JS2028EE/ESP32_FC/hardware/revB/Sources.md

# Manufacturer sources for Rev B

- ESP32-S3 module, pins, memory options and temperature: https://www.espressif.com/sites/default/files/documentation/esp32-s3-wroom-1_wroom-1u_datasheet_en.pdf
- ESP32 schematic/USB guidelines: https://docs.espressif.com/projects/esp-hardware-design-guidelines/en/latest/esp32s3/schematic-checklist.html
- BMI088: https://www.bosch-sensortec.com/media/boschsensortec/downloads/datasheets/bst-bmi088-ds001.pdf
- BMP280: https://www.bosch-sensortec.com/media/boschsensortec/downloads/datasheets/bst-bmp280-ds001.pdf
- LMR36510 component/layout guidance, sections 5 and 8.5: https://www.ti.com/lit/ds/symlink/lmr36510.pdf
- AP63203 components/layout: https://www.diodes.com/assets/Datasheets/AP63200-AP63201-AP63203-AP63205.pdf
- Sensor LDO: https://www.ti.com/lit/ds/symlink/tlv755p.pdf
- LVC125 buffer: https://www.ti.com/lit/ds/symlink/sn74lvc125a.pdf
- DMN2056U SOT23, low gate-voltage ratings: https://www.diodes.com/datasheet/download/DMN2056U.pdf
- Littelfuse 476 fuse (2026-02-25 revision, electrical ratings p1 and lands p3): https://www.littelfuse.com/assetdocs/littelfuse-fuse-476-datasheet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
- C27 Panasonic EEUFR1H470 dimensions/rating: https://industrial.panasonic.com/ww/products/pt/aluminum-cap-lead/models/EEUFR1H470
- C8 KEMET 220nF/100V 0805: https://yageogroup.com/download/specsheet/C0805C224K1RACTU
- Murata 22uF/16V X5R 0805: https://www.murata.com/en-global/products/productdetail?partno=GRM21BR61C226ME44%23
- Murata 22uF/25V X7R 1210: https://www.murata.com/en-us/products/productdetail.aspx?partno=GRM32ER71E226ME15%23 (tolerance suffix differs for the selected K/10% part)
- Murata 4.7uF/16V X5R 0603: https://www.murata.com/products/productdetail?partno=GRM188R61C475KE11%23
- TI reference BOM identifying GRM32ER72A225KA35L as 2.2uF/100V X7R 1210: https://www.ti.com/lit/pdf/tidrrv2
- Kingbright 0603 indicator: https://www.kingbrightusa.com/images/catalog/spec/apt1608lzgck.pdf
- Bourns inductors: https://www.bourns.com/docs/Product-Datasheets/SRP6060FA.pdf and https://www.bourns.com/docs/Product-Datasheets/SRP5030T.pdf
- JLCPCB fabrication capabilities and nominal stackups: https://jlcpcb.com/capabilities/pcb-capabilities and https://jlcpcb.com/impedance
- Reference ESC: https://holybro.com/products/tekko32-f4-4in1-50a-esc and current scale by PCB revision: https://docs.holybro.com/esc/current-sensor-scale

Reviewed for this revision on 2026-10-15. Manufacturer documentation and sourcing can change; verify the purchased variants. These sources support design choices, not a claim that the assembled board has passed testing.
