JS2028EE/ESP32_FC/THIRD_PARTY_NOTICES.md

# Licensing and third-party material

No project-wide open-source license has been selected for this repository. Public availability alone is not a project-wide license grant. No MIT, CERN-OHL or other license is asserted here on the owner's behalf. A license can be added separately by the owner.

The KiCad project contains embedded/library-derived symbols and footprints, including locally adapted footprints. Upstream library copyright, attribution and applicable terms remain relevant; this document does not replace or override them. Consult the license and attribution for the precise KiCad library revision used before redistributing library material. The original library revision is not pinned in this snapshot.

Manufacturer datasheets and product pages are linked in [Sources.md](hardware/revB/Sources.md); those documents are not copied into the repository. Manufacturer names, part numbers and trademarks identify compatible design references and do not imply sponsorship or certification.
