JS2028EE/ESP32_FC/hardware/revB/Assembly_Top.pdf

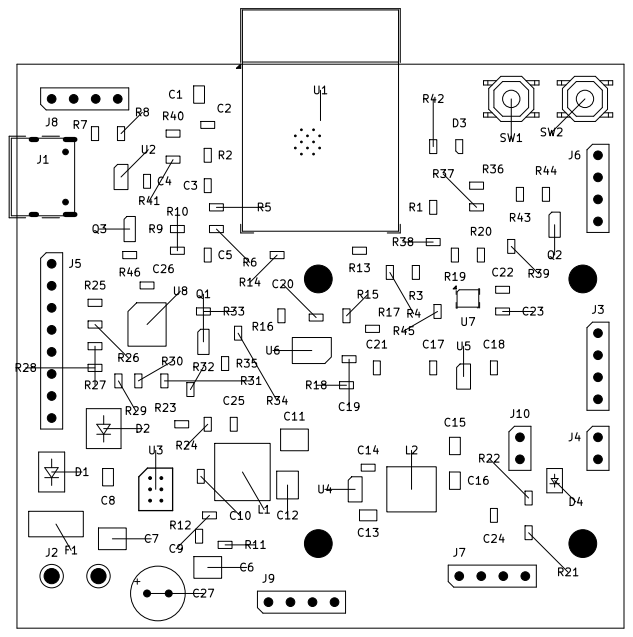
[picture p7: page 1]
