JS2028EE/ESP32_FC/hardware/revB/ESP32_FC.kicad_pcb

## KiCad design hardware/revB/ESP32_FC.kicad_pcb (2026-10-16)

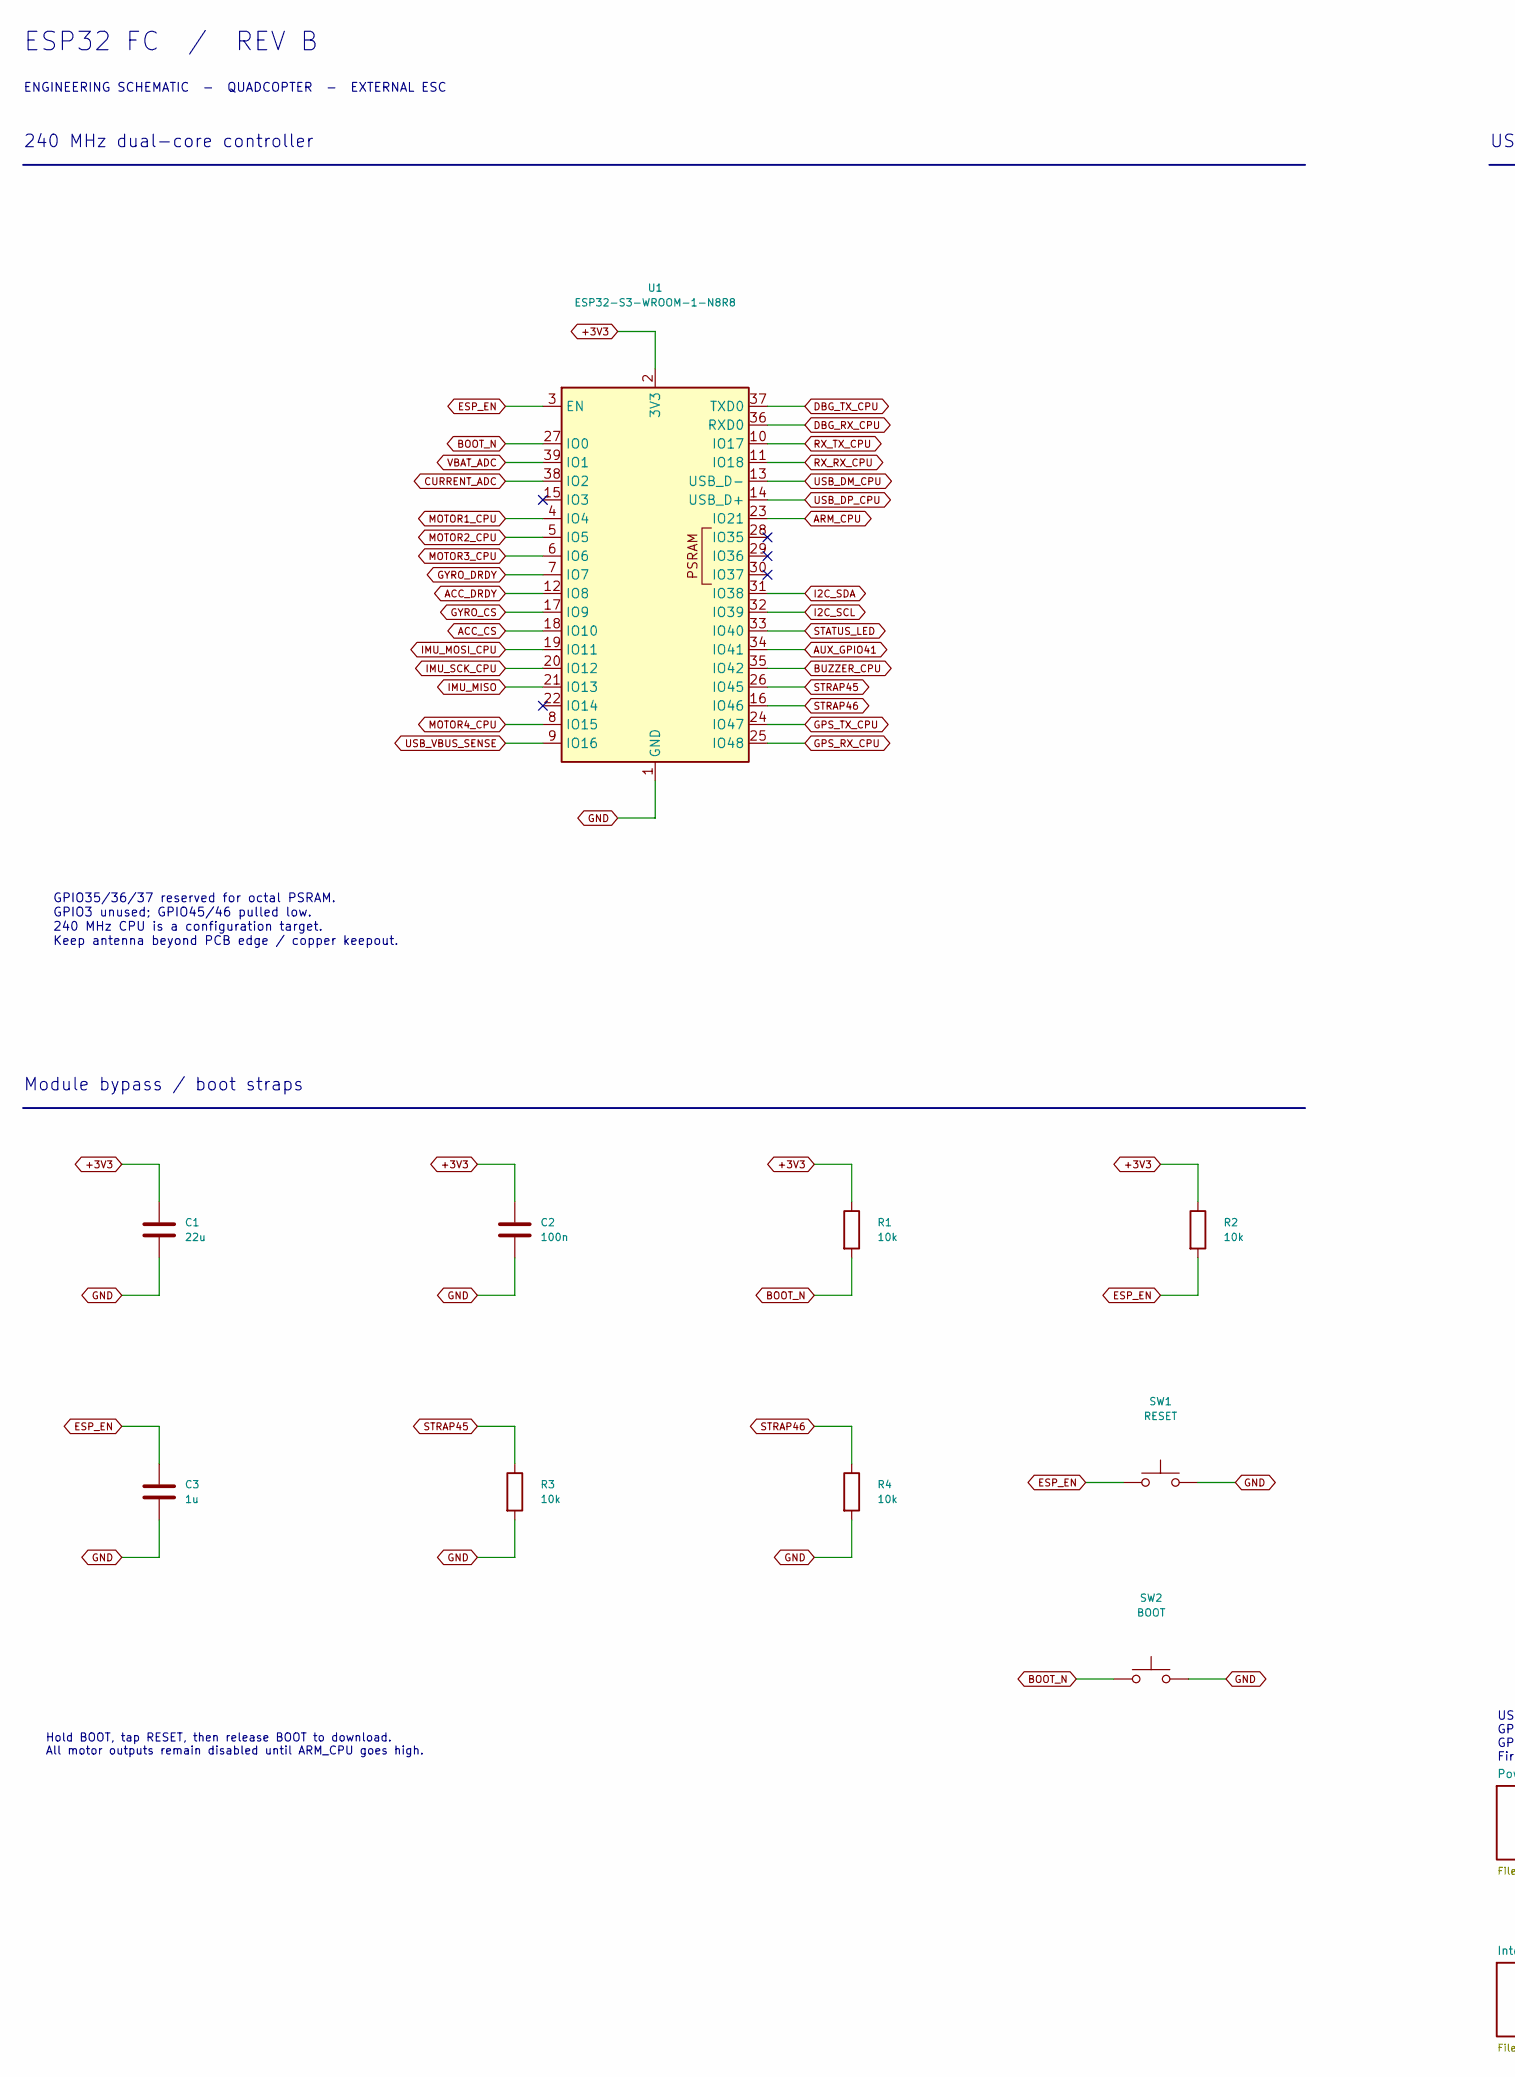
[picture p8: schematic ESP32_FC.kicad_sch, 01 Processor and USB, part in row 1, column 1]

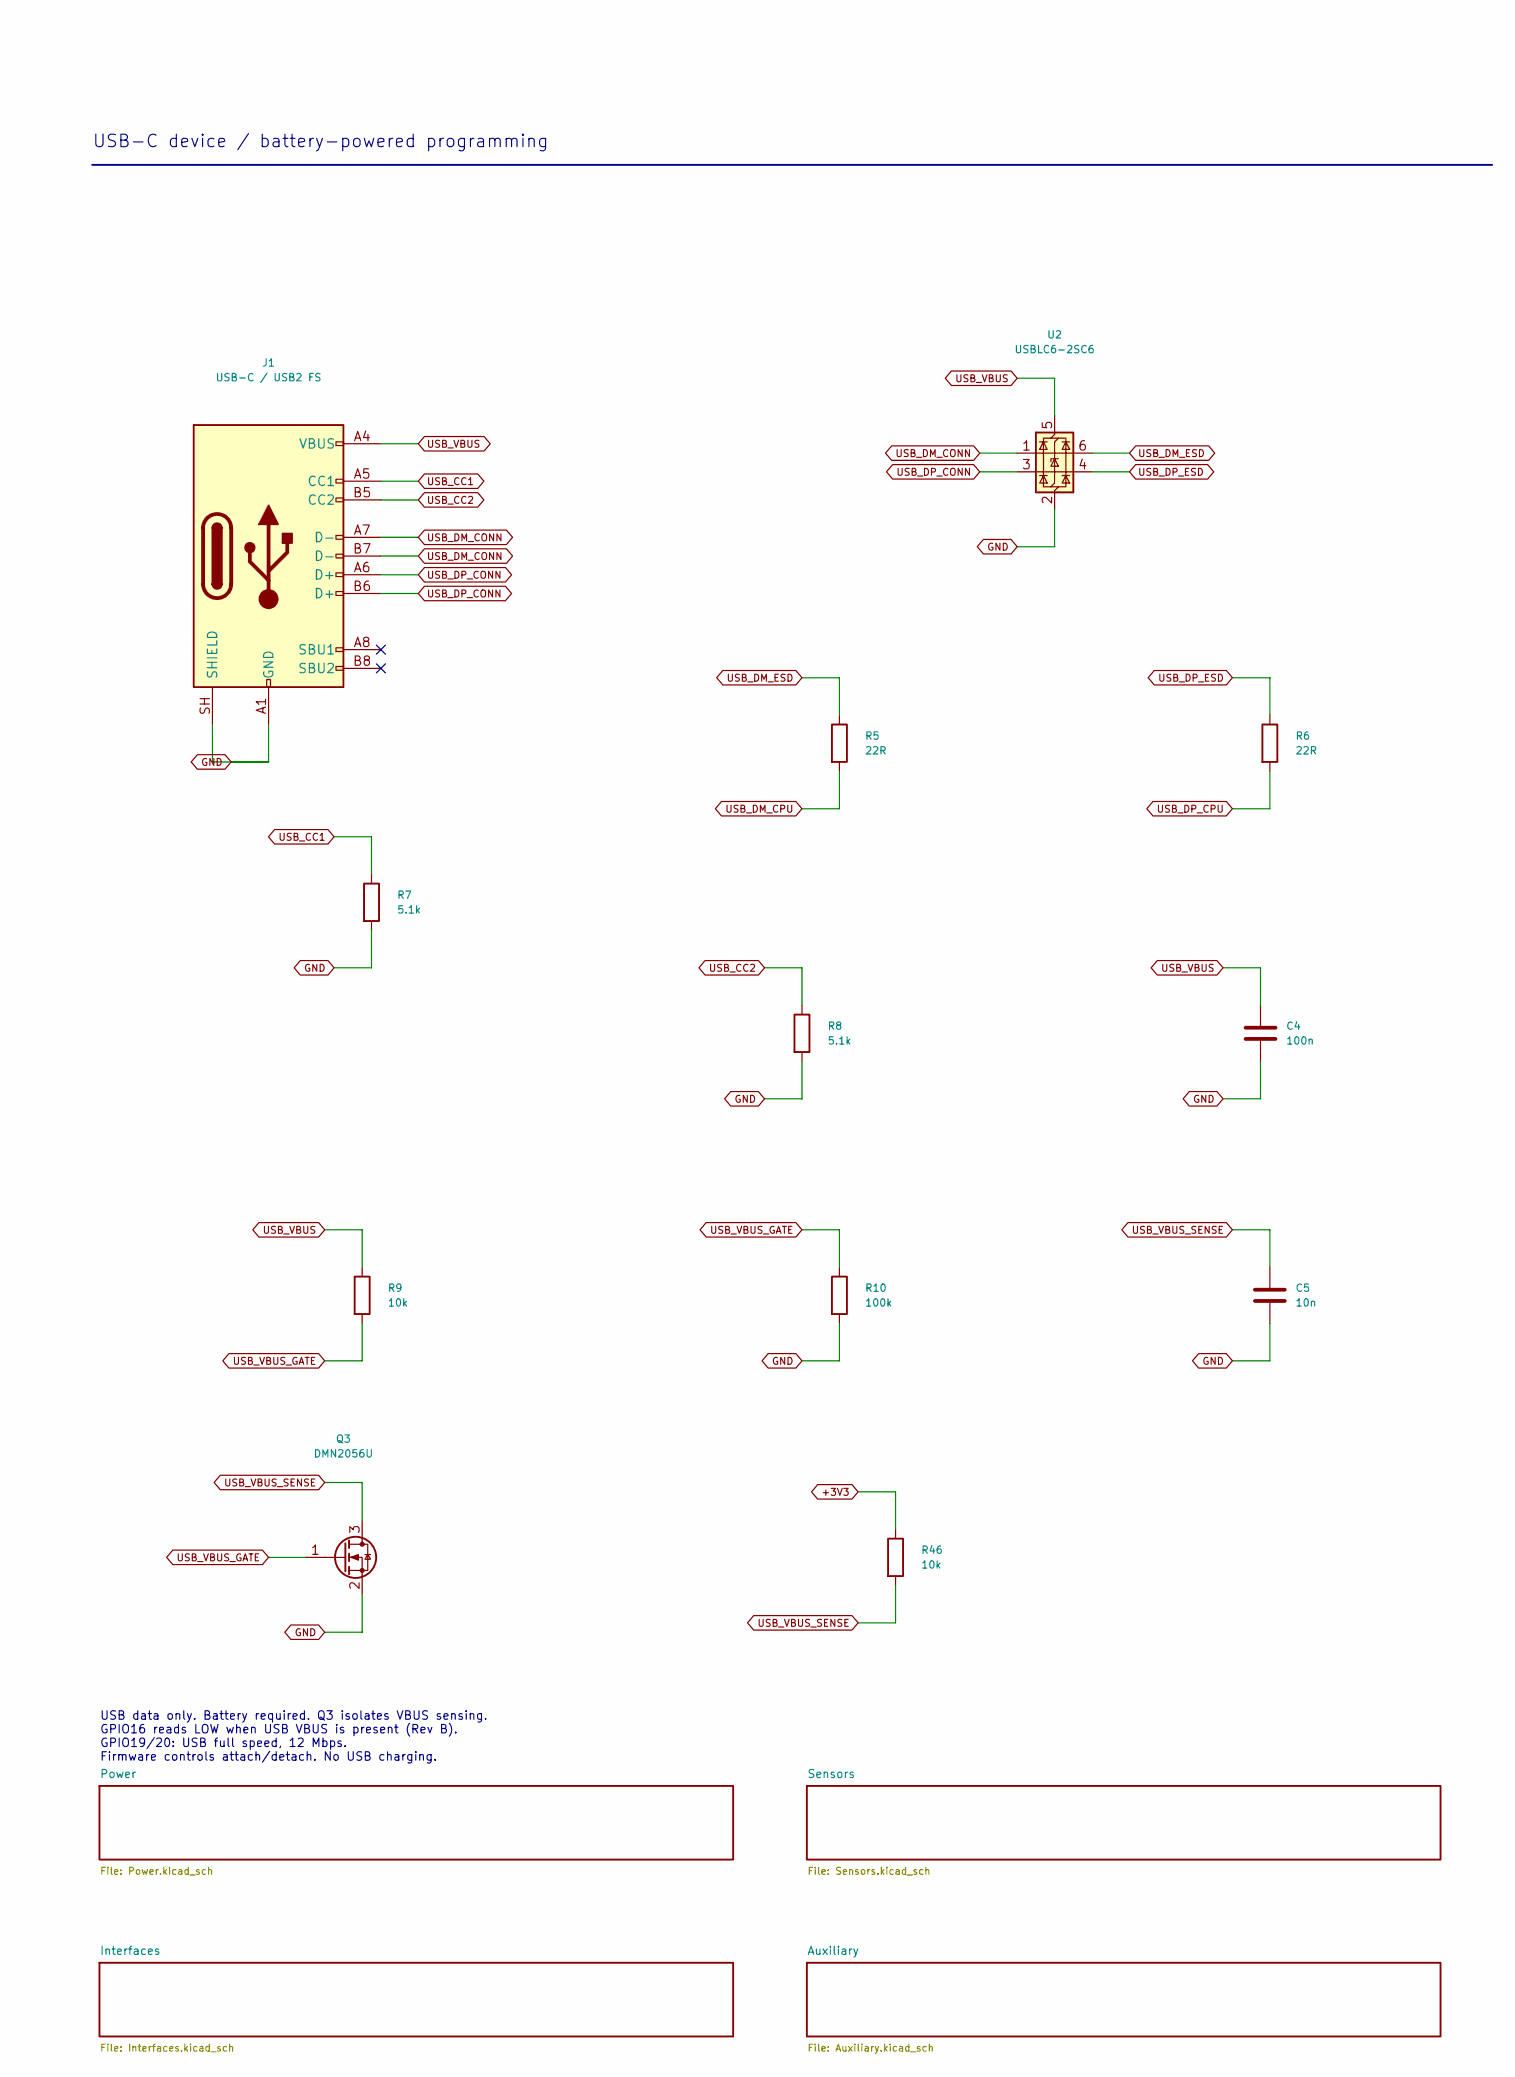
[picture p9: schematic ESP32_FC.kicad_sch, 01 Processor and USB, part in row 1, column 2]

Parts:
C1: 22u; C_0805_2012Metric; MPN GRM21BR61C226ME44L
C2, C4: 100n; C_0603_1608Metric; MPN GRM188R71C104KA01D
C3: 1u; C_0603_1608Metric; MPN GRM188R71C105KA12D
C5: 10n; C_0603_1608Metric; MPN GRM188R71H103KA01D
J1: USB-C / USB2 FS; USB_C_HRO_Edge; MPN TYPE-C-31-M-12
Q3: DMN2056U; SOT-23; MPN DMN2056U-7
R1, R2, R3, R4, R9, R46: 10k; R_0603_1608Metric; MPN RC0603FR-0710KL
R5, R6: 22R; R_0603_1608Metric; MPN RC0603FR-0722RL
R7, R8: 5.1k; R_0603_1608Metric; MPN RC0603FR-075K1L
R10: 100k; R_0603_1608Metric; MPN RC0603FR-07100KL
SW1: RESET; SW_SPST_TL3342; MPN TL3342F160QG
SW2: BOOT; SW_SPST_TL3342; MPN TL3342F160QG
U1: ESP32-S3-WROOM-1-N8R8; ESP32_S3_WROOM_Edge; MPN ESP32-S3-WROOM-1-N8R8
U2: USBLC6-2SC6; SOT-23-6; MPN USBLC6-2SC6

Connections:
+3V3: C1.1, C2.1, R1.1, R2.1, R46.1, U1.2 (3V3); also elsewhere on the board
ACC_CS: U1.18 (IO10); also elsewhere on the board
ACC_DRDY: U1.12 (IO8); also elsewhere on the board
ARM_CPU: U1.23 (IO21); also elsewhere on the board
AUX_GPIO41: U1.34 (IO41); also elsewhere on the board
BOOT_N: R1.2, SW2.1, U1.27 (IO0)
BUZZER_CPU: U1.35 (IO42); also elsewhere on the board
CURRENT_ADC: U1.38 (IO2); also elsewhere on the board
DBG_RX_CPU: U1.36 (RXD0); also elsewhere on the board
DBG_TX_CPU: U1.37 (TXD0); also elsewhere on the board
ESP_EN: C3.1, R2.2, SW1.1, U1.3 (EN)
GND: C1.2, C2.2, C3.2, C4.2, C5.2, J1.A1 (GND), J1.A12 (GND), J1.B1 (GND), J1.B12 (GND), J1.SH (SHIELD), Q3.2 (S), R3.2, R4.2, R7.2, R8.2, R10.2, SW1.2, SW2.2, U1.1 (GND), U1.40 (GND), U1.41 (GND), U2.2 (GND); also elsewhere on the board
GPS_RX_CPU: U1.25 (IO48); also elsewhere on the board
GPS_TX_CPU: U1.24 (IO47); also elsewhere on the board
GYRO_CS: U1.17 (IO9); also elsewhere on the board
GYRO_DRDY: U1.7 (IO7); also elsewhere on the board
I2C_SCL: U1.32 (IO39); also elsewhere on the board
I2C_SDA: U1.31 (IO38); also elsewhere on the board
IMU_MISO: U1.21 (IO13); also elsewhere on the board
IMU_MOSI_CPU: U1.19 (IO11); also elsewhere on the board
IMU_SCK_CPU: U1.20 (IO12); also elsewhere on the board
MOTOR1_CPU: U1.4 (IO4); also elsewhere on the board
MOTOR2_CPU: U1.5 (IO5); also elsewhere on the board
MOTOR3_CPU: U1.6 (IO6); also elsewhere on the board
MOTOR4_CPU: U1.8 (IO15); also elsewhere on the board
RX_RX_CPU: U1.11 (IO18); also elsewhere on the board
RX_TX_CPU: U1.10 (IO17); also elsewhere on the board
STATUS_LED: U1.33 (IO40); also elsewhere on the board
STRAP45: R3.1, U1.26 (IO45)
STRAP46: R4.1, U1.16 (IO46)
USB_CC1: J1.A5 (CC1), R7.1
USB_CC2: J1.B5 (CC2), R8.1
USB_DM_CONN: J1.A7 (D-), J1.B7 (D-), U2.1 (I/O1)
USB_DM_CPU: R5.2, U1.13 (USB_D-)
USB_DM_ESD: R5.1, U2.6 (I/O1)
USB_DP_CONN: J1.A6 (D+), J1.B6 (D+), U2.3 (I/O2)
USB_DP_CPU: R6.2, U1.14 (USB_D+)
USB_DP_ESD: R6.1, U2.4 (I/O2)
USB_VBUS: C4.1, J1.A4 (VBUS), J1.A9 (VBUS), J1.B4 (VBUS), J1.B9 (VBUS), R9.1, U2.5 (VBUS)
USB_VBUS_GATE: Q3.1 (G), R9.2, R10.1
USB_VBUS_SENSE: C5.1, Q3.3 (D), R46.2, U1.9 (IO16)
VBAT_ADC: U1.39 (IO1); also elsewhere on the board

Notes on the sheet:
ESP32 FC / REV B
ENGINEERING SCHEMATIC - QUADCOPTER - EXTERNAL ESC
240 MHz dual-core controller
GPIO35/36/37 reserved for octal PSRAM. GPIO3 unused; GPIO45/46 pulled low. 240 MHz CPU is a configuration target. Keep antenna beyond PCB edge / copper keepout.
Module bypass / boot straps
Hold BOOT, tap RESET, then release BOOT to download. All motor outputs remain disabled until ARM_CPU goes high.
USB-C device / battery-powered programming
USB data only. Battery required. Q3 isolates VBUS sensing. GPIO16 reads LOW when USB VBUS is present (Rev B). GPIO19/20: USB full speed, 12 Mbps. Firmware controls attach/detach. No USB charging.

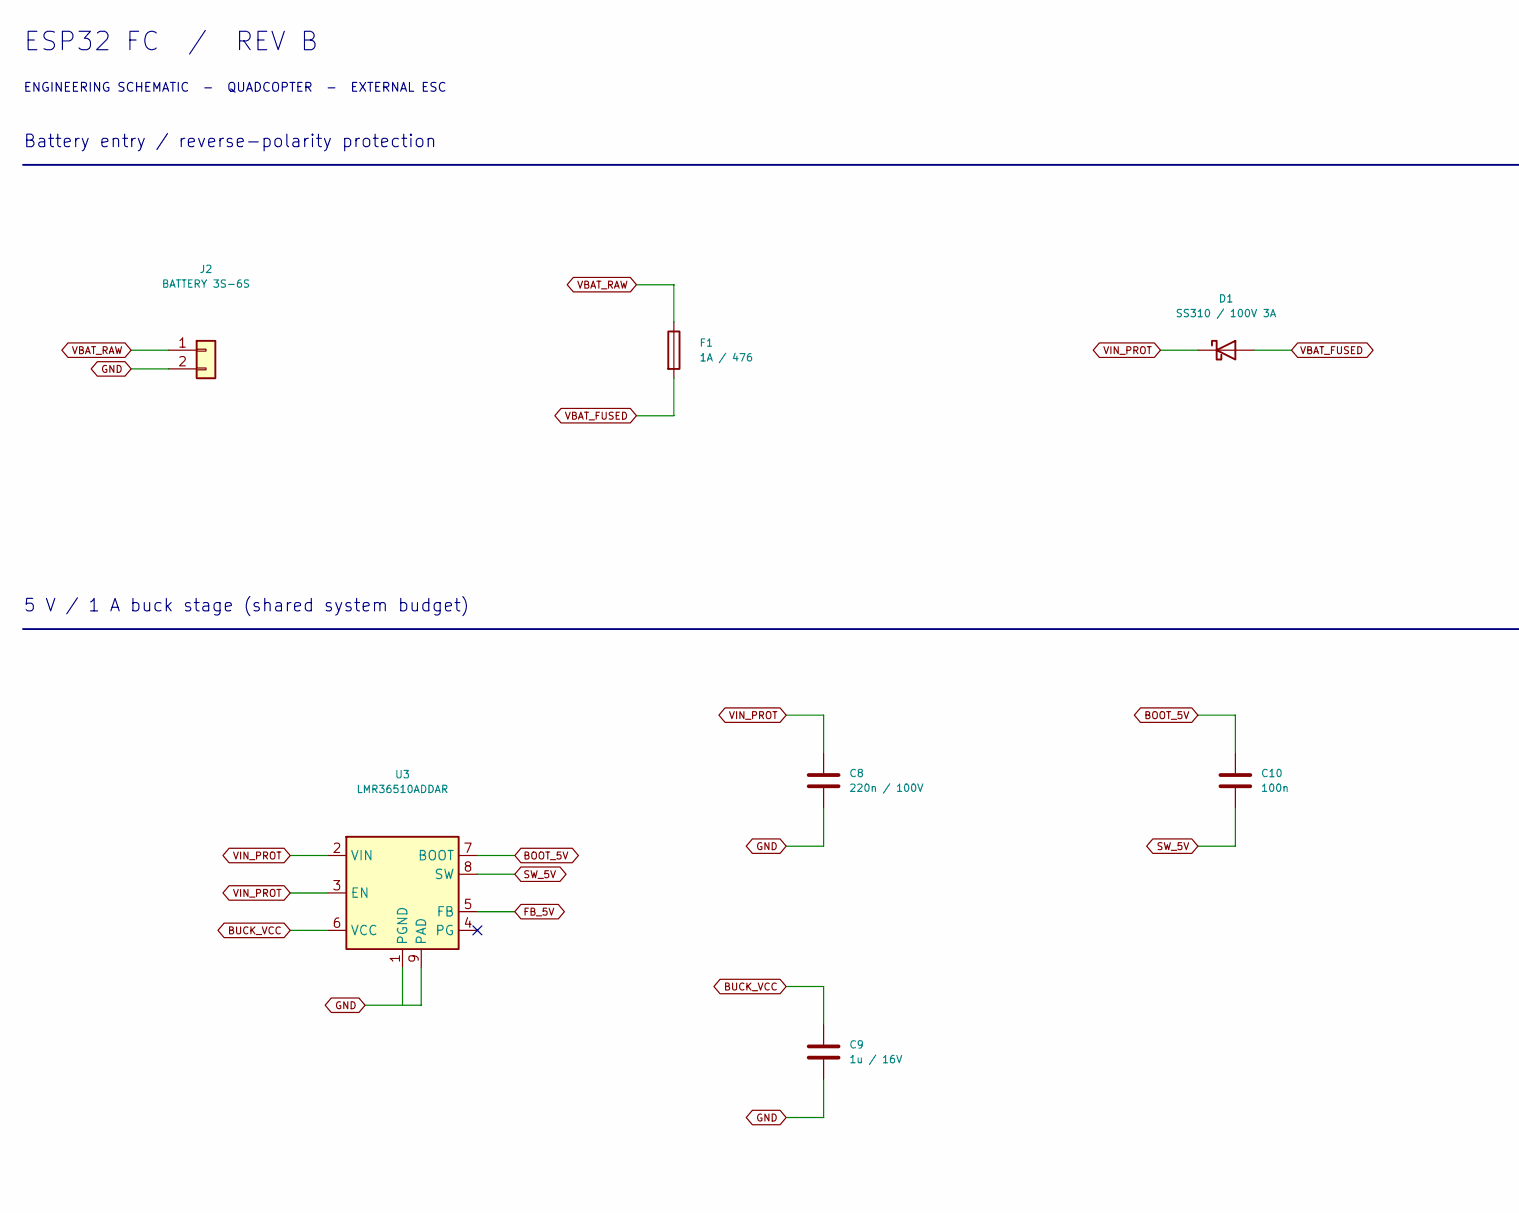
[picture p10: schematic Power.kicad_sch, 02 Battery and regulation, part in row 1, column 1]

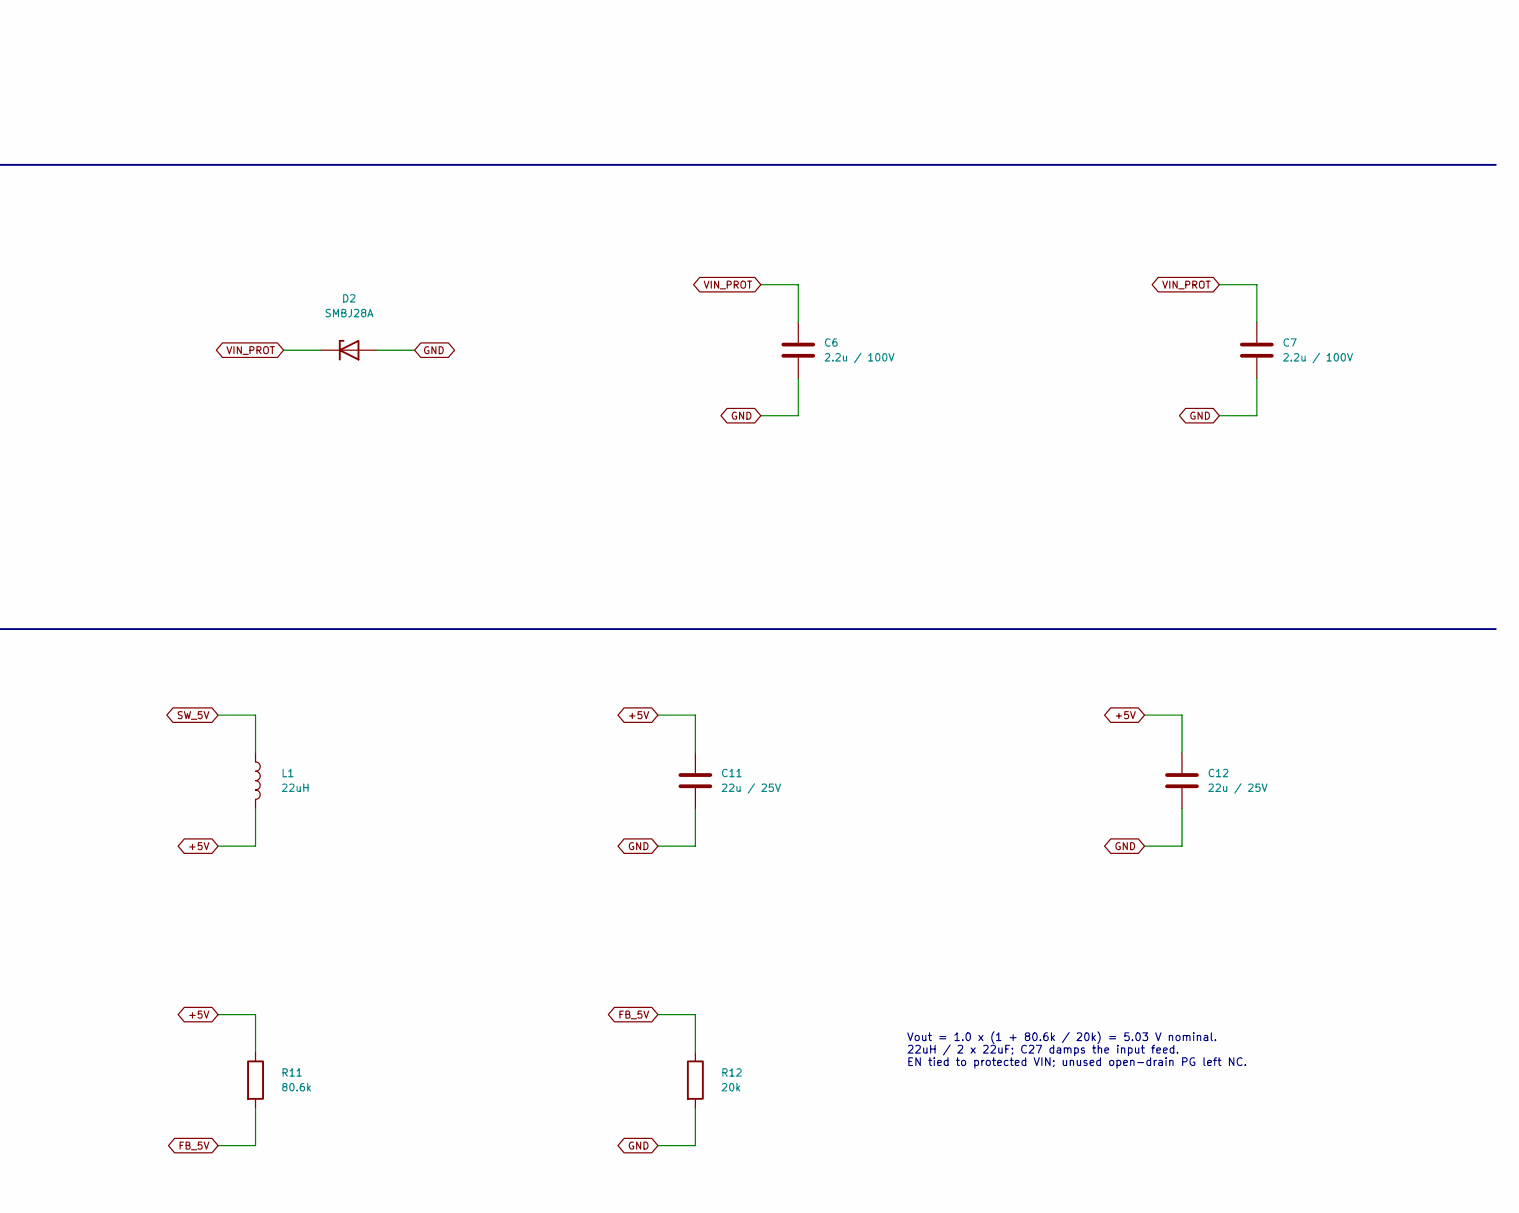
[picture p11: schematic Power.kicad_sch, 02 Battery and regulation, part in row 1, column 2]

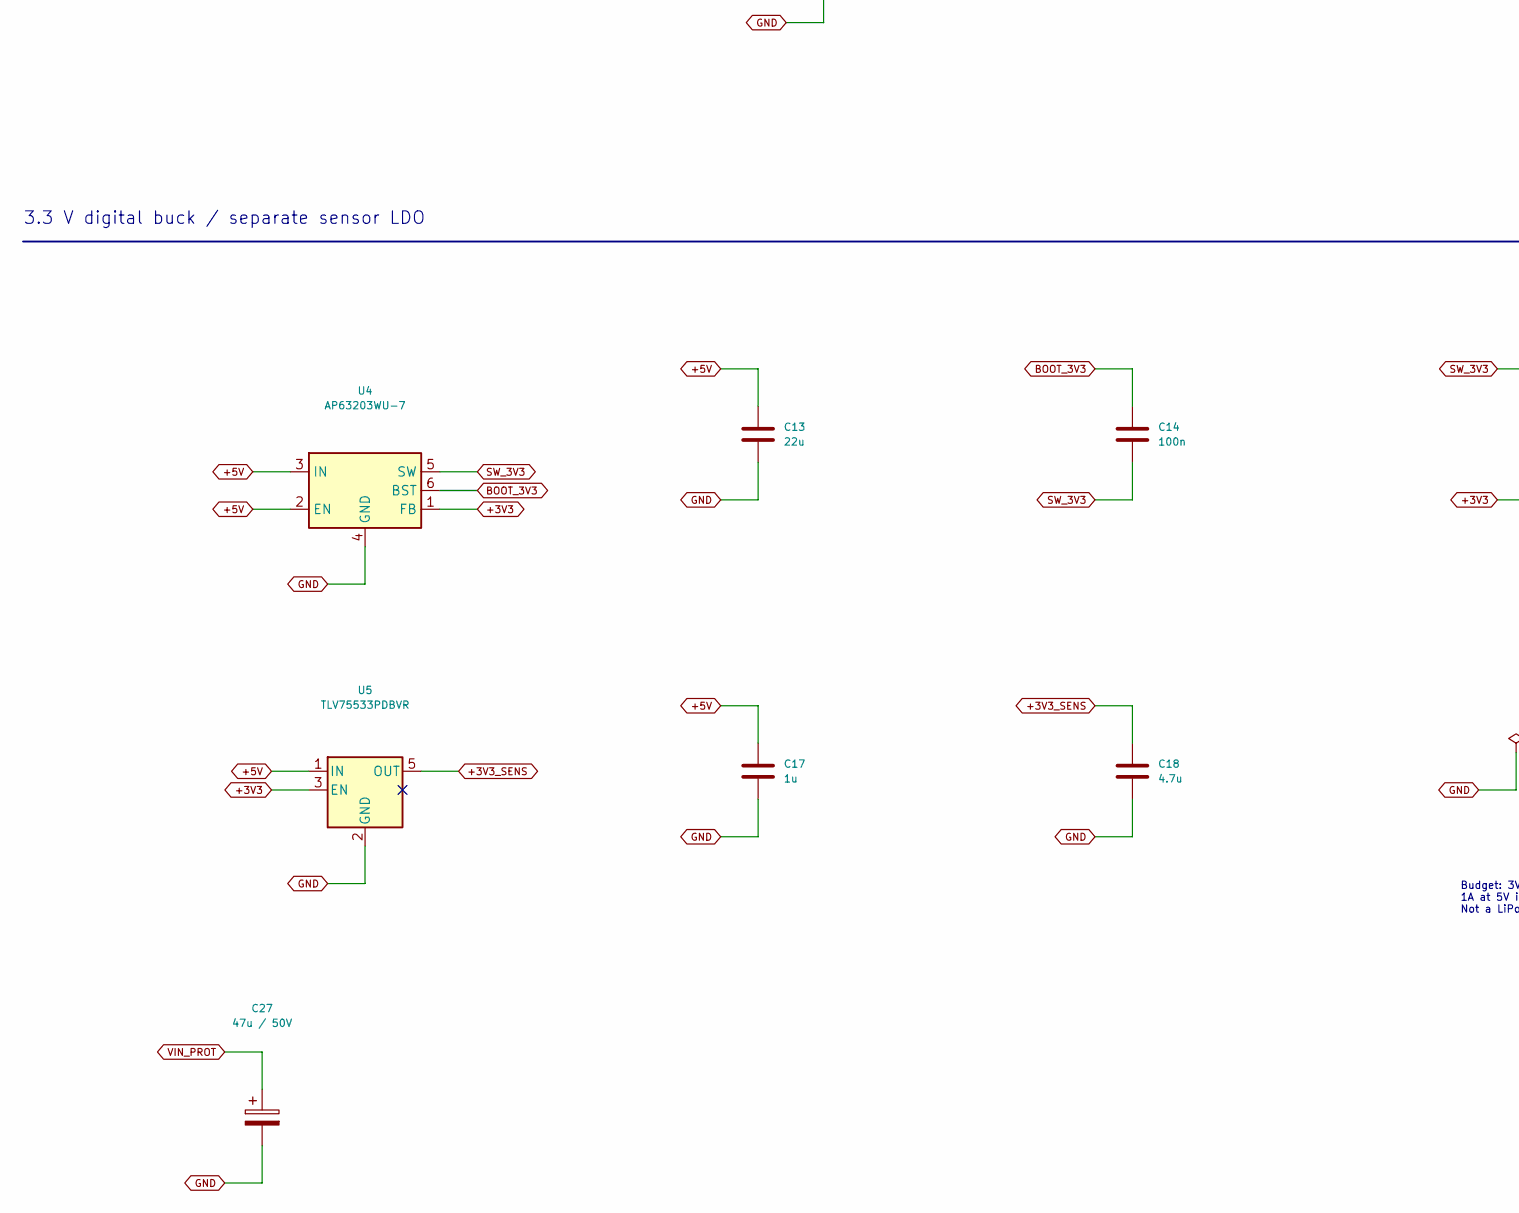
[picture p12: schematic Power.kicad_sch, 02 Battery and regulation, part in row 2, column 1]

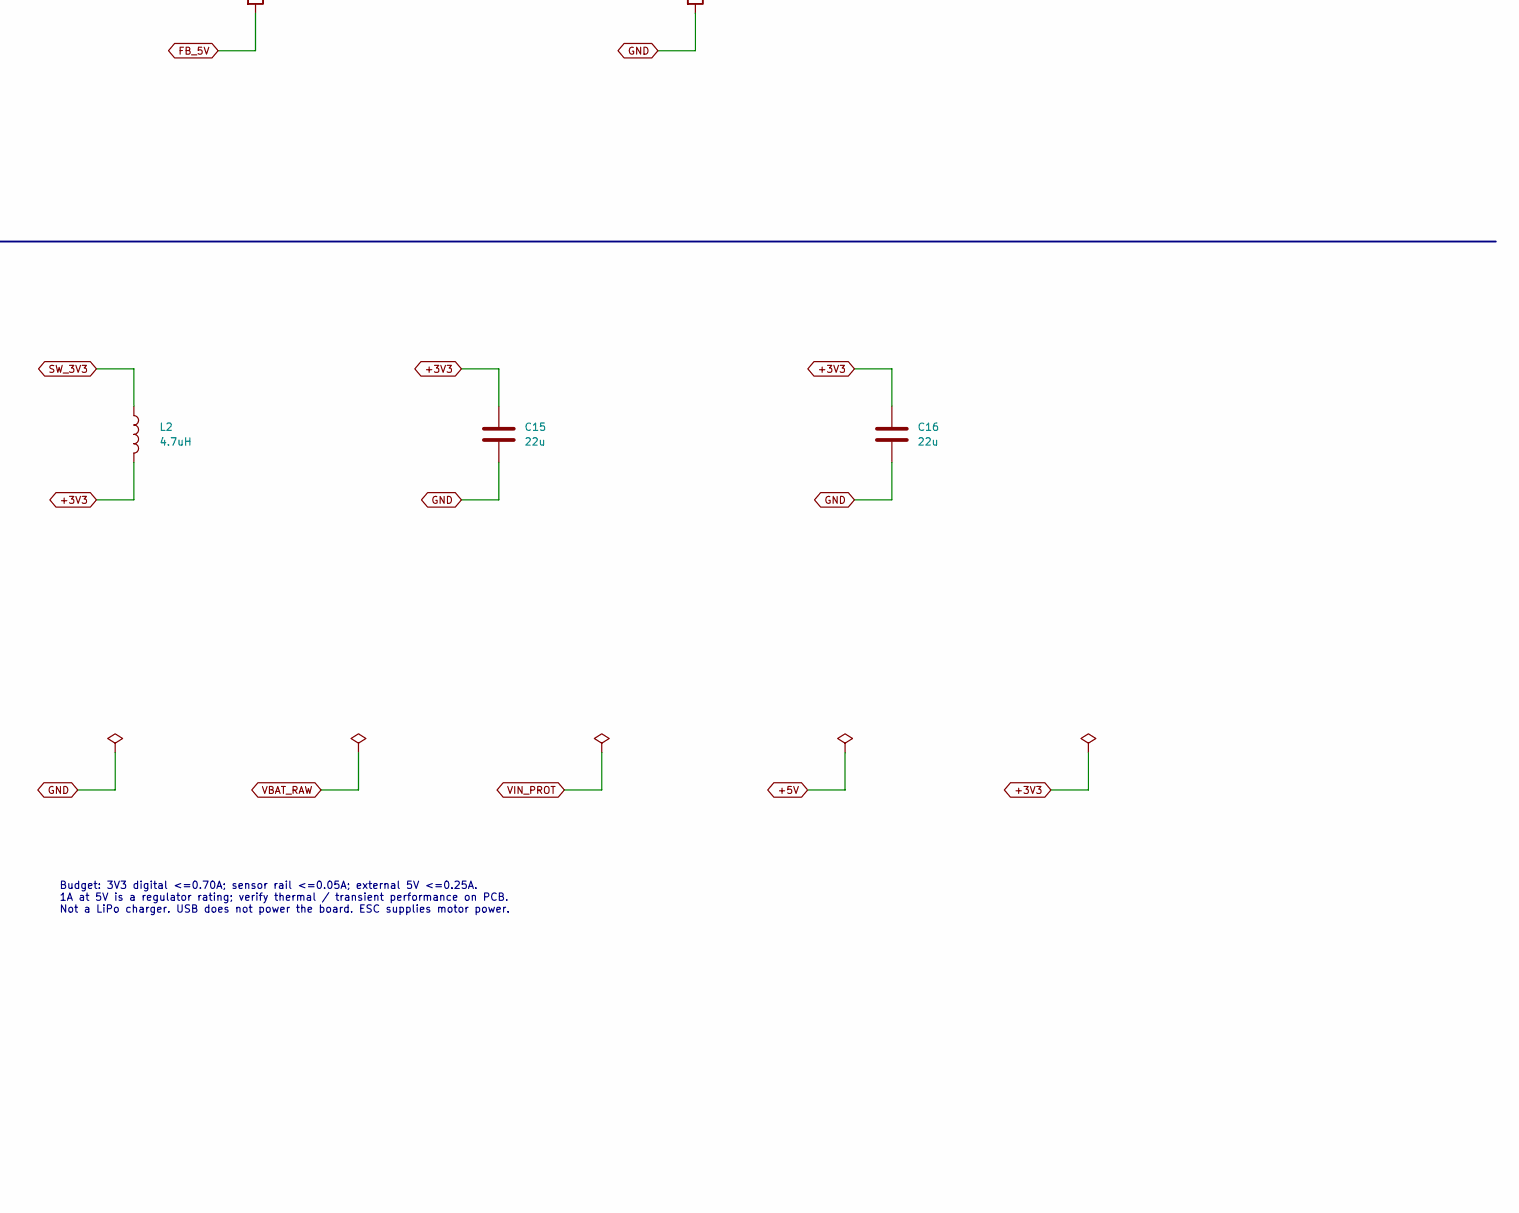
[picture p13: schematic Power.kicad_sch, 02 Battery and regulation, part in row 2, column 2]

Parts:
C6, C7: 2.2u / 100V; C_1210_3225Metric; MPN GRM32ER72A225KA35L
C8: 220n / 100V; C_0805_2012Metric; MPN C0805C224K1RACTU
C9: 1u / 16V; C_0603_1608Metric; MPN GRM188R71C105KA12D
C10, C14: 100n; C_0603_1608Metric; MPN GRM188R71C104KA01D
C11, C12: 22u / 25V; C_1210_3225Metric; MPN GRM32ER71E226KE15L
C13, C15, C16: 22u; C_0805_2012Metric; MPN GRM21BR61C226ME44L
C17: 1u; C_0603_1608Metric; MPN GRM188R71C105KA12D
C18: 4.7u; C_0603_1608Metric; MPN GRM188R61C475KE11D
C27: 47u / 50V; CP_Radial_D6.3mm_P2.50mm; MPN EEUFR1H470
D1: SS310 / 100V 3A; D_SMA; MPN SS310-13-F
D2: SMBJ28A; D_SMB; MPN SMBJ28A-13-F
F1: 1A / 476; Fuse_Littelfuse_476; MPN 0476001.MR
J2: BATTERY 3S-6S; SolderWire-1sqmm_1x02_P5.4mm_D1.4mm_OD2.7mm; MPN WIRE CONNECTION - NO FITTED PART
L1: 22uH; L_Bourns_SRP6060FA; MPN SRP6060FA-220M
L2: 4.7uH; L_Bourns_SRP5030T; MPN SRP5030T-4R7M
R11: 80.6k; R_0603_1608Metric; MPN RC0603FR-0780K6L
R12: 20k; R_0603_1608Metric; MPN RC0603FR-0720KL
U3: LMR36510ADDAR; Texas_HTSOP-8-1EP_3.9x4.9mm_P1.27mm_EP2.95x4.9mm_Mask2.4x3.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; MPN LMR36510ADDAR
U4: AP63203WU-7; TSOT-23-6; MPN AP63203WU-7
U5: TLV75533PDBVR; SOT-23-5; MPN TLV75533PDBVR

Connections:
+3V3: C15.1, C16.1, L2.2, U4.1 (FB), U5.3 (EN); also elsewhere on the board
+3V3_SENS: C18.1, U5.5 (OUT); also elsewhere on the board
+5V: C11.1, C12.1, C13.1, C17.1, L1.2, R11.1, U4.2 (EN), U4.3 (IN), U5.1 (IN); also elsewhere on the board
BOOT_3V3: C14.1, U4.6 (BST)
BOOT_5V: C10.1, U3.7 (BOOT)
BUCK_VCC: C9.1, U3.6 (VCC)
FB_5V: R11.2, R12.1, U3.5 (FB)
GND: C6.2, C7.2, C8.2, C9.2, C11.2, C12.2, C13.2, C15.2, C16.2, C17.2, C18.2, C27.2, D2.2 (A), J2.2, R12.2, U3.1 (PGND), U3.9 (PAD), U4.4 (GND), U5.2 (GND); also elsewhere on the board
SW_3V3: C14.2, L2.1, U4.5 (SW)
SW_5V: C10.2, L1.1, U3.8 (SW)
VBAT_FUSED: D1.2 (A), F1.2
VBAT_RAW: F1.1, J2.1; also elsewhere on the board
VIN_PROT: C6.1, C7.1, C8.1, C27.1, D1.1 (K), D2.1 (K), U3.2 (VIN), U3.3 (EN); also elsewhere on the board

Notes on the sheet:
ESP32 FC / REV B
ENGINEERING SCHEMATIC - QUADCOPTER - EXTERNAL ESC
Battery entry / reverse-polarity protection
5 V / 1 A buck stage (shared system budget)
Vout = 1.0 x (1 + 80.6k / 20k) = 5.03 V nominal. 22uH / 2 x 22uF; C27 damps the input feed. EN tied to protected VIN; unused open-drain PG left NC.
3.3 V digital buck / separate sensor LDO
Budget: 3V3 digital <=0.70A; sensor rail <=0.05A; external 5V <=0.25A. 1A at 5V is a regulator rating; verify thermal / transient performance on PCB. Not a LiPo charger. USB does not power the board. ESC supplies motor power.
