JS2028EE/ESP32_FC/hardware/revB/ESP32_FC.kicad_pcb

## KiCad design hardware/revB/ESP32_FC.kicad_pcb (continued)

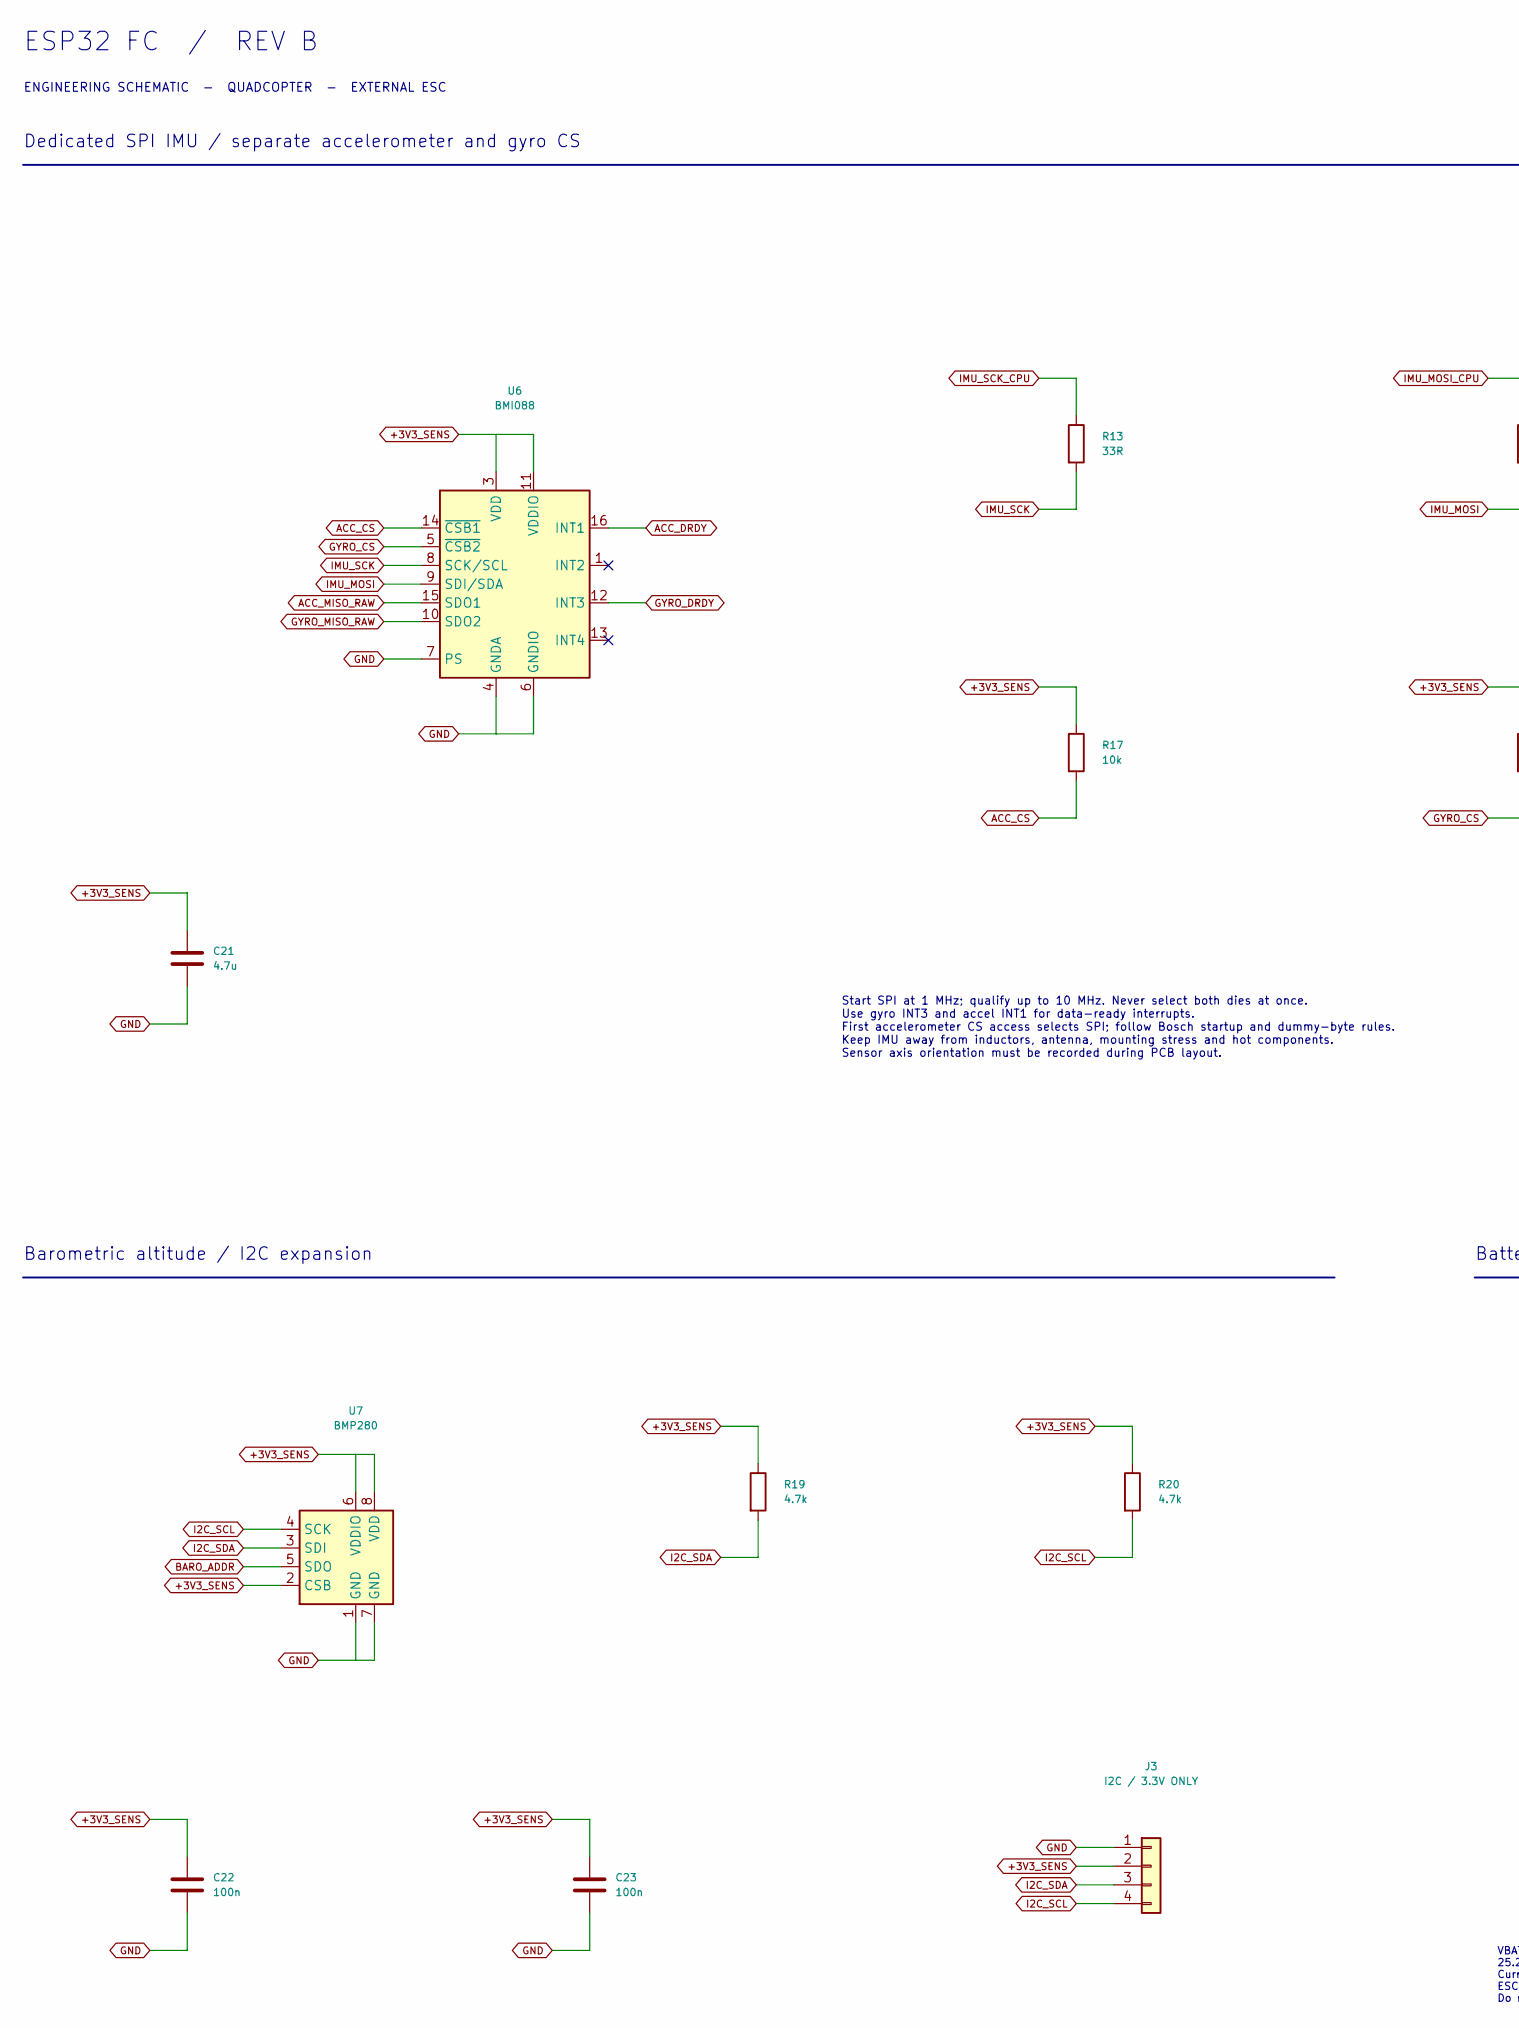
[picture p14: schematic Sensors.kicad_sch, 03 Sensors and monitoring, part in row 1, column 1]

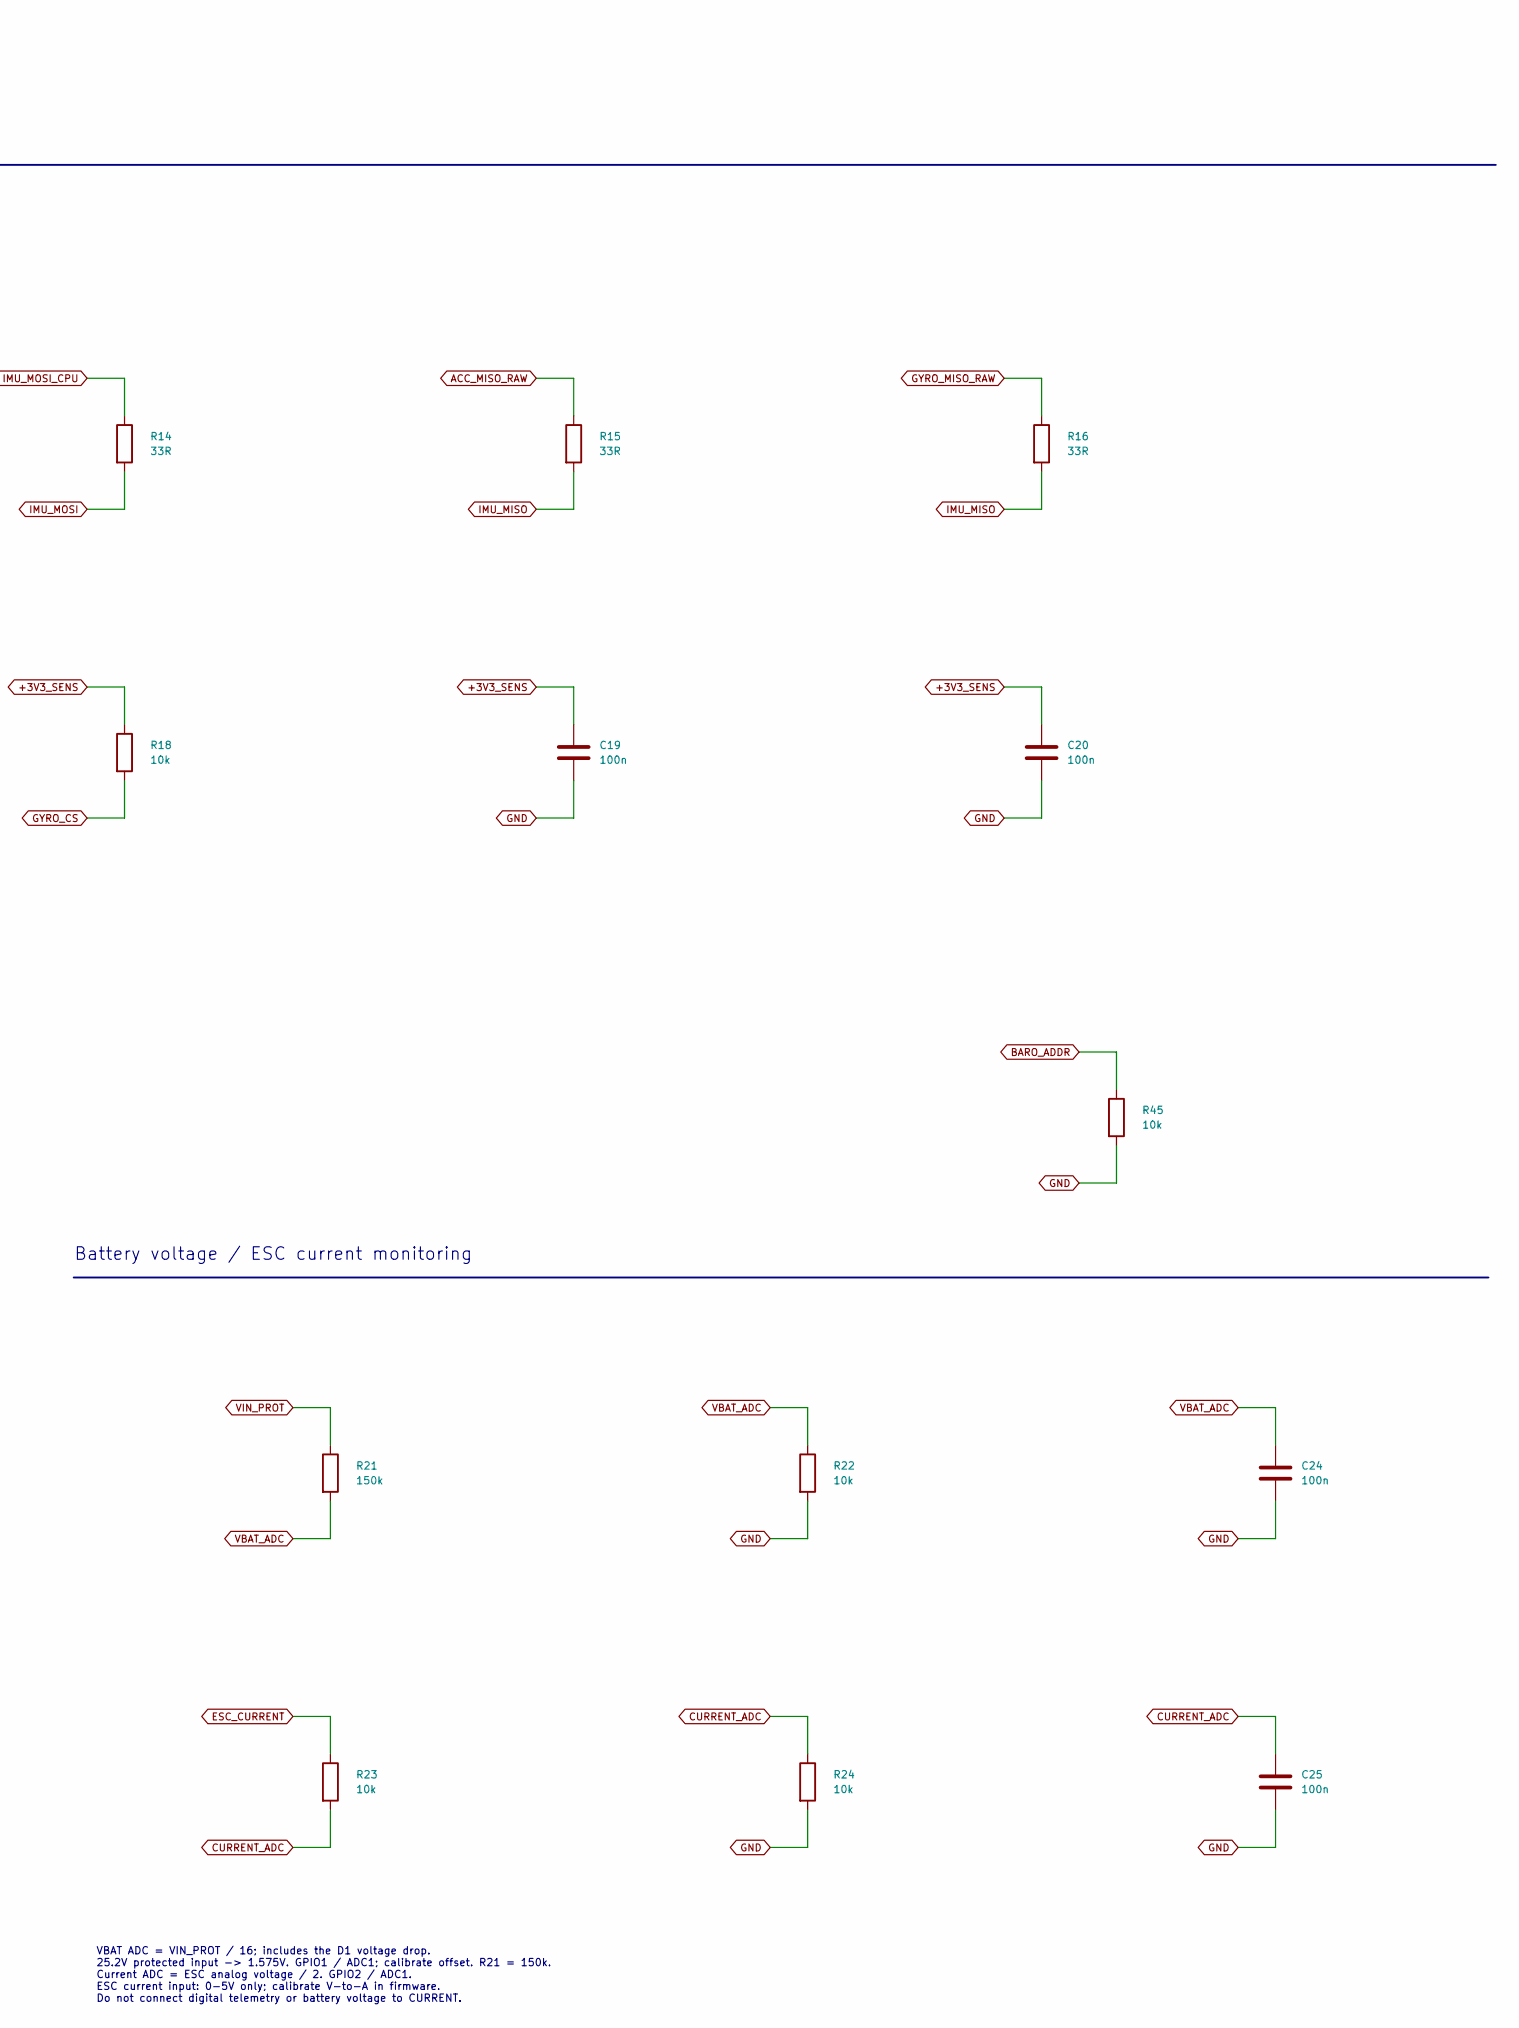
[picture p15: schematic Sensors.kicad_sch, 03 Sensors and monitoring, part in row 1, column 2]

Parts:
C19, C20, C22, C23, C24, C25: 100n; C_0603_1608Metric; MPN GRM188R71C104KA01D
C21: 4.7u; C_0603_1608Metric; MPN GRM188R61C475KE11D
J3: I2C / 3.3V ONLY; PinHeader_1x04_P2.54mm_Vertical; MPN TSW-104-07-G-S
R13, R14, R15, R16: 33R; R_0603_1608Metric; MPN RC0603FR-0733RL
R17, R18, R23, R24, R45: 10k; R_0603_1608Metric; MPN RC0603FR-0710KL
R19, R20: 4.7k; R_0603_1608Metric; MPN RC0603FR-074K7L
R21: 150k; R_0603_1608Metric; MPN RT0603BRD07150KL
R22: 10k; R_0603_1608Metric; MPN RT0603BRD0710KL
U6: BMI088; Bosch_LGA-16_4.5x3mm_P0.5mm_LayoutBorder7x1y_ClockwisePinNu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; MPN BMI088
U7: BMP280; BMP280_SilkClear; MPN BMP280

Connections:
+3V3_SENS: C19.1, C20.1, C21.1, C22.1, C23.1, J3.2, R17.1, R18.1, R19.1, R20.1, U6.3 (VDD), U6.11 (VDDIO), U7.2 (CSB), U7.6 (VDDIO), U7.8 (VDD); also elsewhere on the board
ACC_CS: R17.2, U6.14 (~CSB1); also elsewhere on the board
ACC_DRDY: U6.16 (INT1); also elsewhere on the board
ACC_MISO_RAW: R15.1, U6.15 (SDO1)
BARO_ADDR: R45.1, U7.5 (SDO)
CURRENT_ADC: C25.1, R23.2, R24.1; also elsewhere on the board
ESC_CURRENT: R23.1; also elsewhere on the board
GND: C19.2, C20.2, C21.2, C22.2, C23.2, C24.2, C25.2, J3.1, R22.2, R24.2, R45.2, U6.2 (GNDA), U6.4 (GNDA), U6.6 (GNDIO), U6.7 (PS), U7.1 (GND), U7.7 (GND); also elsewhere on the board
GYRO_CS: R18.2, U6.5 (~CSB2); also elsewhere on the board
GYRO_DRDY: U6.12 (INT3); also elsewhere on the board
GYRO_MISO_RAW: R16.1, U6.10 (SDO2)
I2C_SCL: J3.4, R20.2, U7.4 (SCK); also elsewhere on the board
I2C_SDA: J3.3, R19.2, U7.3 (SDI); also elsewhere on the board
IMU_MISO: R15.2, R16.2; also elsewhere on the board
IMU_MOSI: R14.2, U6.9 (SDI/SDA)
IMU_MOSI_CPU: R14.1; also elsewhere on the board
IMU_SCK: R13.2, U6.8 (SCK/SCL)
IMU_SCK_CPU: R13.1; also elsewhere on the board
VBAT_ADC: C24.1, R21.2, R22.1; also elsewhere on the board
VIN_PROT: R21.1; also elsewhere on the board

Notes on the sheet:
ESP32 FC / REV B
ENGINEERING SCHEMATIC - QUADCOPTER - EXTERNAL ESC
Dedicated SPI IMU / separate accelerometer and gyro CS
Start SPI at 1 MHz; qualify up to 10 MHz. Never select both dies at once. Use gyro INT3 and accel INT1 for data-ready interrupts. First accelerometer CS access selects SPI; follow Bosch startup and dummy-byte rules. Keep IMU away from inductors, antenna, mounting stress and hot components. Sensor a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
Barometric altitude / I2C expansion
Battery voltage / ESC current monitoring
VBAT ADC = VIN_PROT / 16; includes the D1 voltage drop. 25.2V protected input -> 1.575V. GPIO1 / ADC1; calibrate offset. R21 = 150k. Current ADC = ESC analog voltage / 2. GPIO2 / ADC1. ESC current input: 0-5V only; calibrate V-to-A in firmware. Do not connect digital telemetry or battery voltage to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

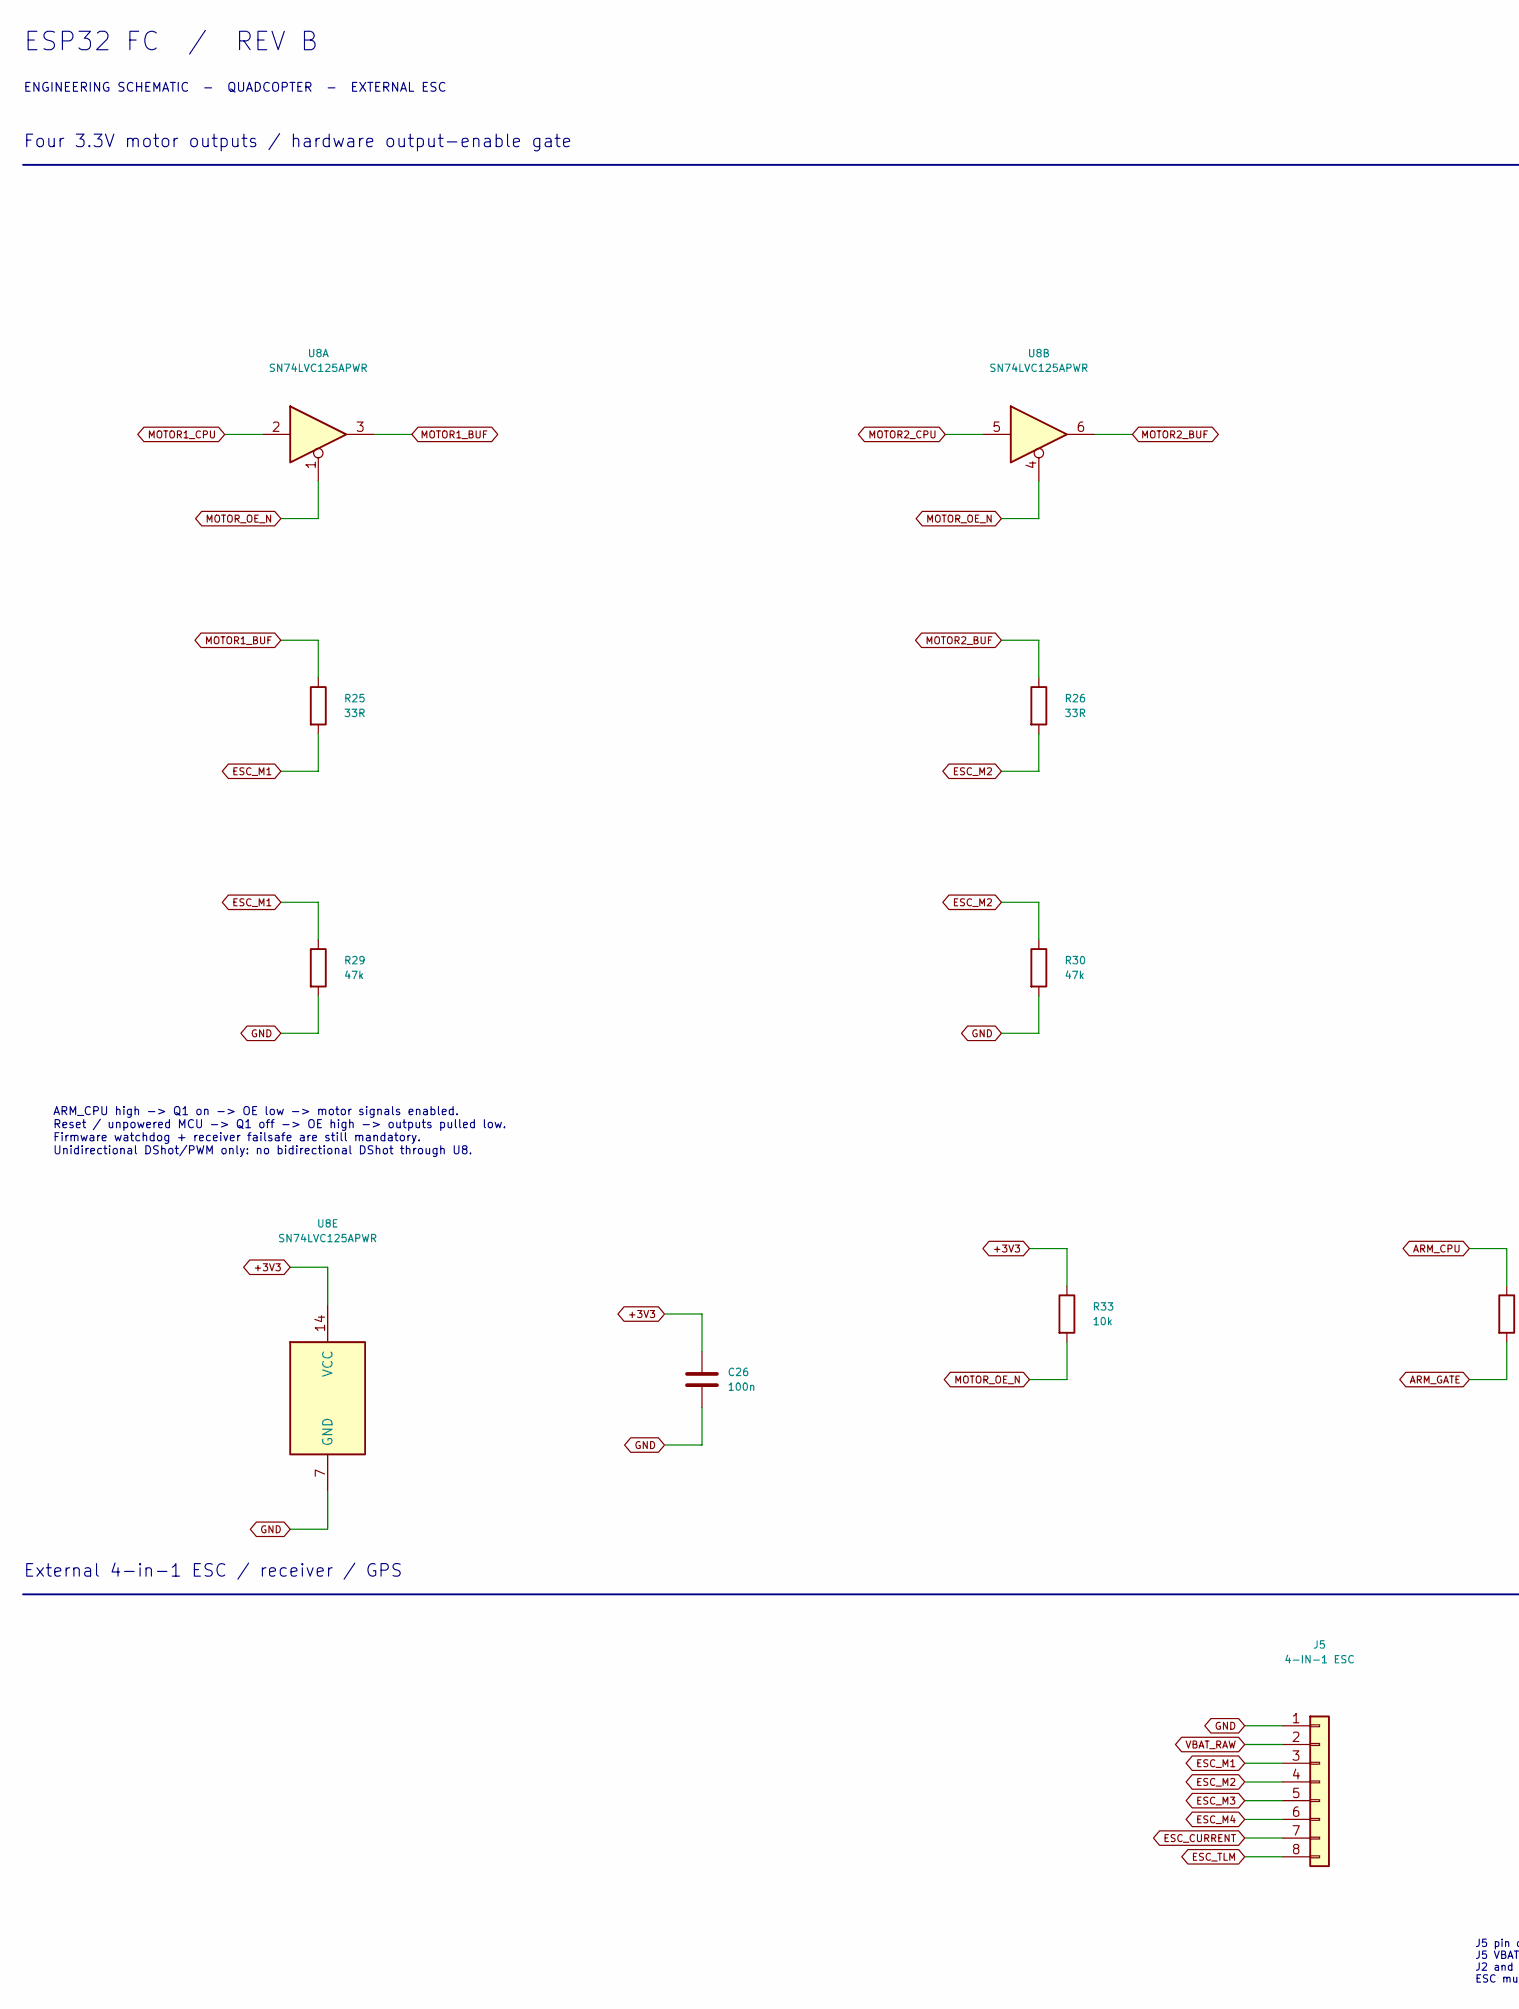
[picture p16: schematic Interfaces.kicad_sch, 04 Motors and ESC interfaces, part in row 1, column 1]

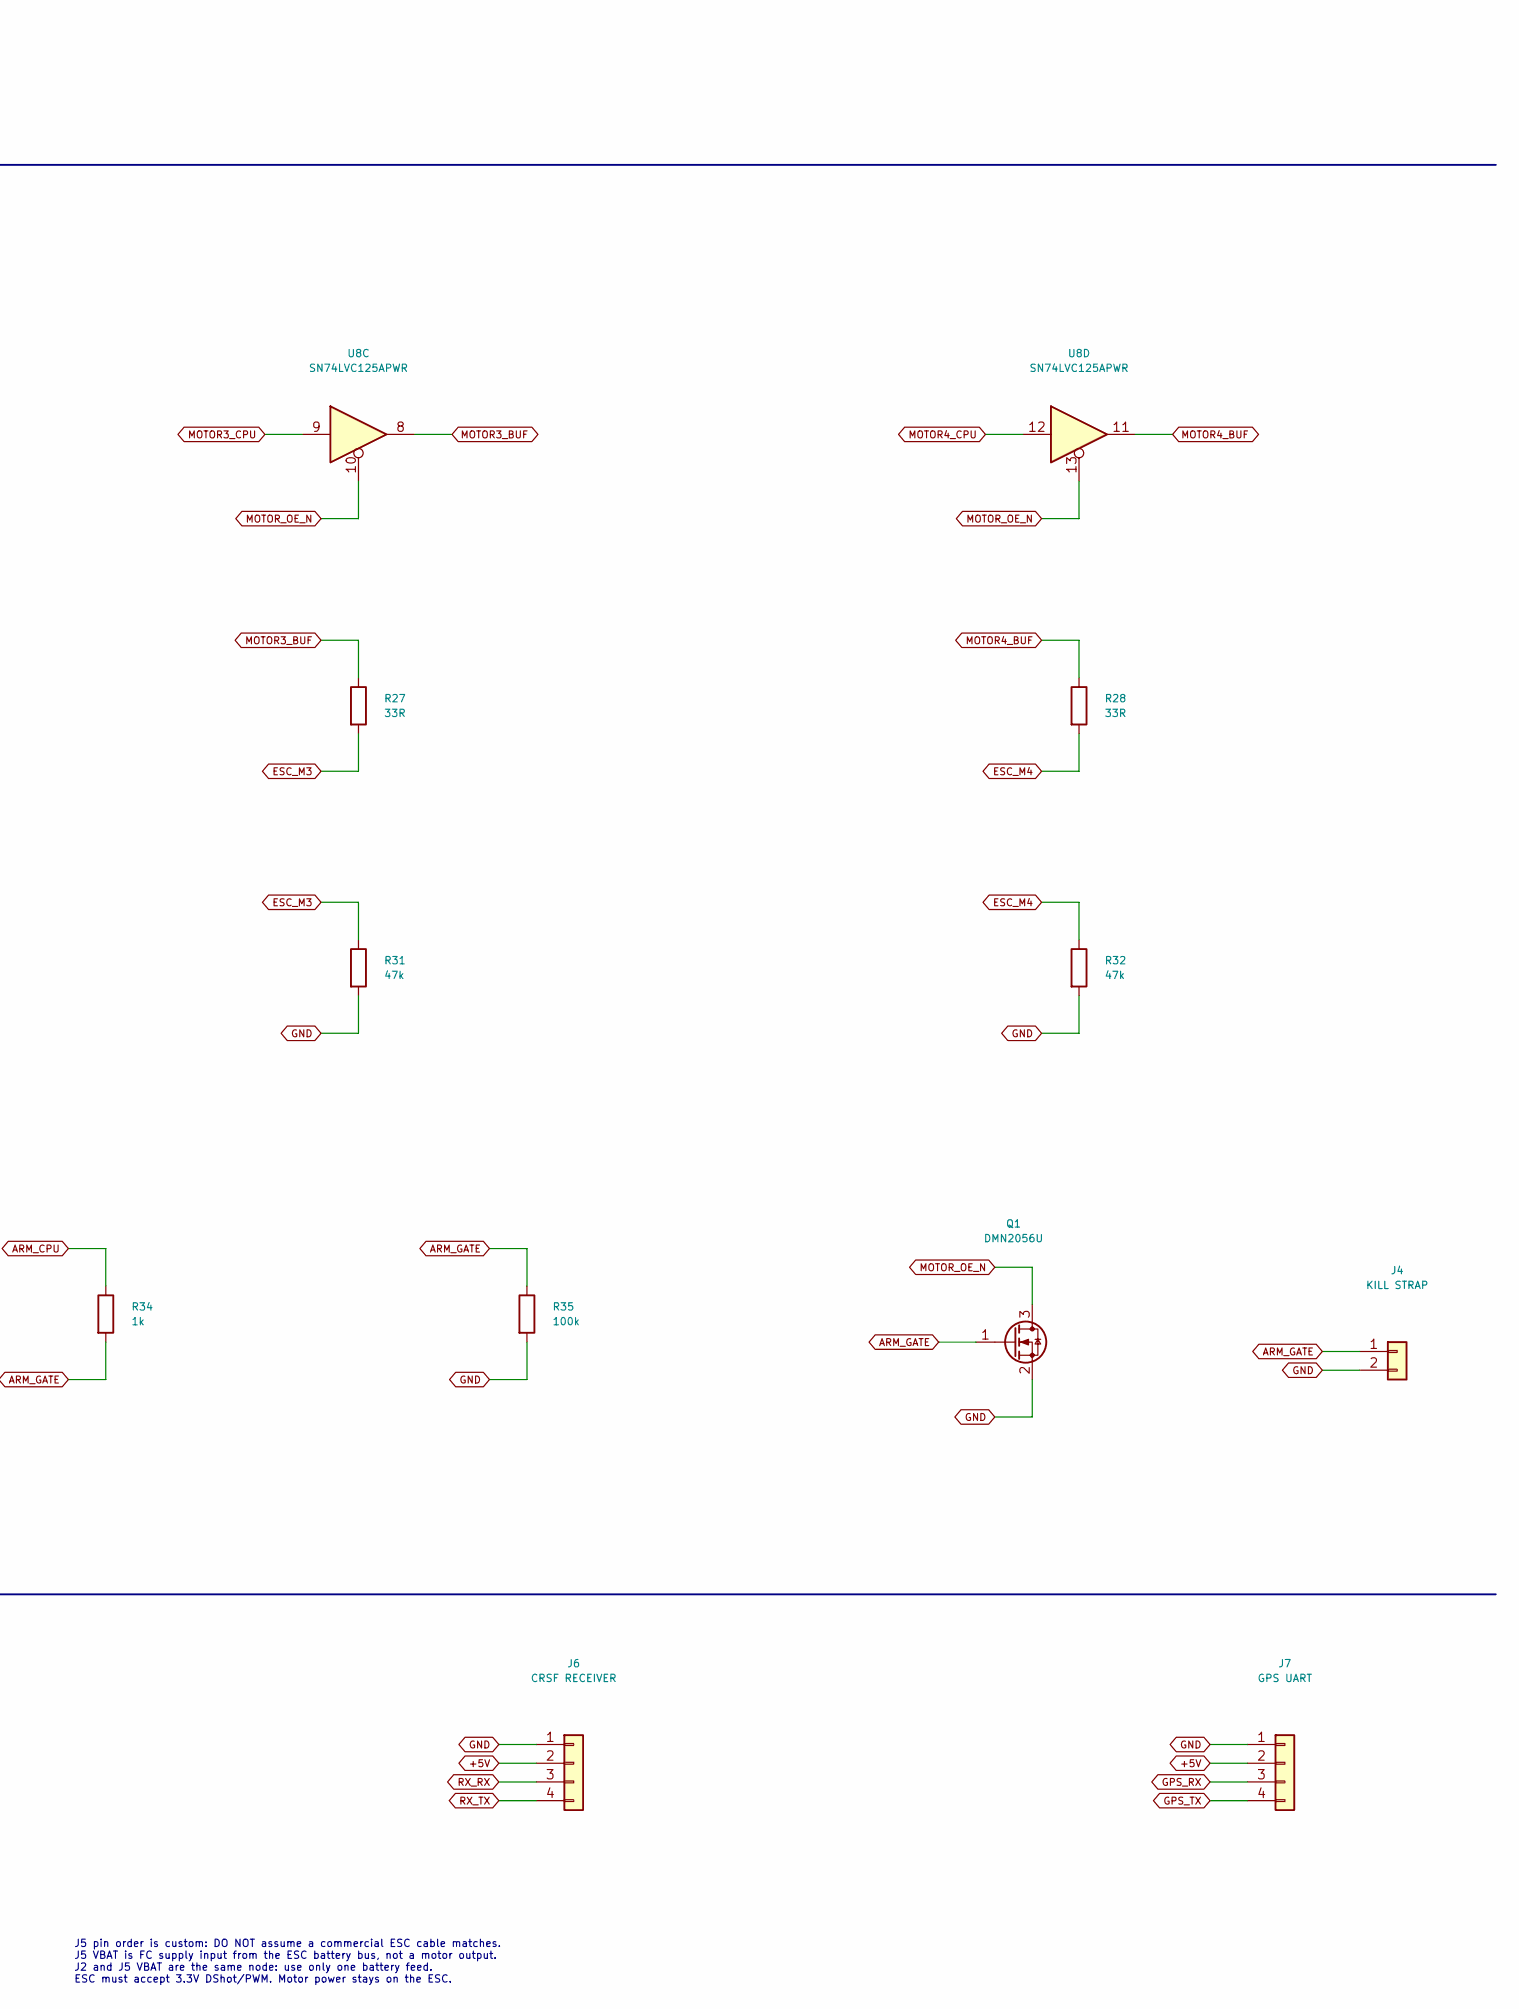
[picture p17: schematic Interfaces.kicad_sch, 04 Motors and ESC interfaces, part in row 1, column 2]

Parts:
C26: 100n; C_0603_1608Metric; MPN GRM188R71C104KA01D
J4: KILL STRAP; PinHeader_1x02_P2.54mm_Vertical; MPN TSW-102-07-G-S
J5: 4-IN-1 ESC; PinHeader_1x08_P2.54mm_Vertical; MPN TSW-108-07-G-S
J6: CRSF RECEIVER; PinHeader_1x04_P2.54mm_Vertical; MPN TSW-104-07-G-S
J7: GPS UART; PinHeader_1x04_P2.54mm_Vertical; MPN TSW-104-07-G-S
Q1: DMN2056U; SOT-23; MPN DMN2056U-7
R25, R26, R27, R28: 33R; R_0603_1608Metric; MPN RC0603FR-0733RL
R29, R30, R31, R32: 47k; R_0603_1608Metric; MPN RC0603FR-0747KL
R33: 10k; R_0603_1608Metric; MPN RC0603FR-0710KL
R34: 1k; R_0603_1608Metric; MPN RC0603FR-071KL
R35: 100k; R_0603_1608Metric; MPN RC0603FR-07100KL
U8: SN74LVC125APWR; TSSOP-14_4.4x5mm_P0.65mm; MPN SN74LVC125APWR

Connections:
+3V3: C26.1, R33.1, U8.14 (VCC); also elsewhere on the board
+5V: J6.2, J7.2; also elsewhere on the board
ARM_CPU: R34.1; also elsewhere on the board
ARM_GATE: J4.1, Q1.1 (G), R34.2, R35.1
ESC_CURRENT: J5.7; also elsewhere on the board
ESC_M1: J5.3, R25.2, R29.1
ESC_M2: J5.4, R26.2, R30.1
ESC_M3: J5.5, R27.2, R31.1
ESC_M4: J5.6, R28.2, R32.1
ESC_TLM: J5.8; also elsewhere on the board
GND: C26.2, J4.2, J5.1, J6.1, J7.1, Q1.2 (S), R29.2, R30.2, R31.2, R32.2, R35.2, U8.7 (GND); also elsewhere on the board
GPS_RX: J7.3; also elsewhere on the board
GPS_TX: J7.4; also elsewhere on the board
MOTOR1_BUF: R25.1, U8.3
MOTOR1_CPU: U8.2; also elsewhere on the board
MOTOR2_BUF: R26.1, U8.6
MOTOR2_CPU: U8.5; also elsewhere on the board
MOTOR3_BUF: R27.1, U8.8
MOTOR3_CPU: U8.9; also elsewhere on the board
MOTOR4_BUF: R28.1, U8.11
MOTOR4_CPU: U8.12; also elsewhere on the board
MOTOR_OE_N: Q1.3 (D), R33.2, U8.1, U8.4, U8.10, U8.13
RX_RX: J6.3; also elsewhere on the board
RX_TX: J6.4; also elsewhere on the board
VBAT_RAW: J5.2; also elsewhere on the board

Notes on the sheet:
ESP32 FC / REV B
ENGINEERING SCHEMATIC - QUADCOPTER - EXTERNAL ESC
Four 3.3V motor outputs / hardware output-enable gate
ARM_CPU high -> Q1 on -> OE low -> motor signals enabled. Reset / unpowered MCU -> Q1 off -> OE high -> outputs pulled low. Firmware watchdog + receiver failsafe are still mandatory. Unidirectional DShot/PWM only: no bidirectional DShot through U8.
External 4-in-1 ESC / receiver / GPS
J5 pin order is custom: DO NOT assume a commercial ESC cable matches. J5 VBAT is FC supply input from the ESC battery bus, not a motor output. J2 and J5 VBAT are the same node: use only one battery feed. ESC must accept 3.3V DShot/PWM. Motor power stays on the ESC.

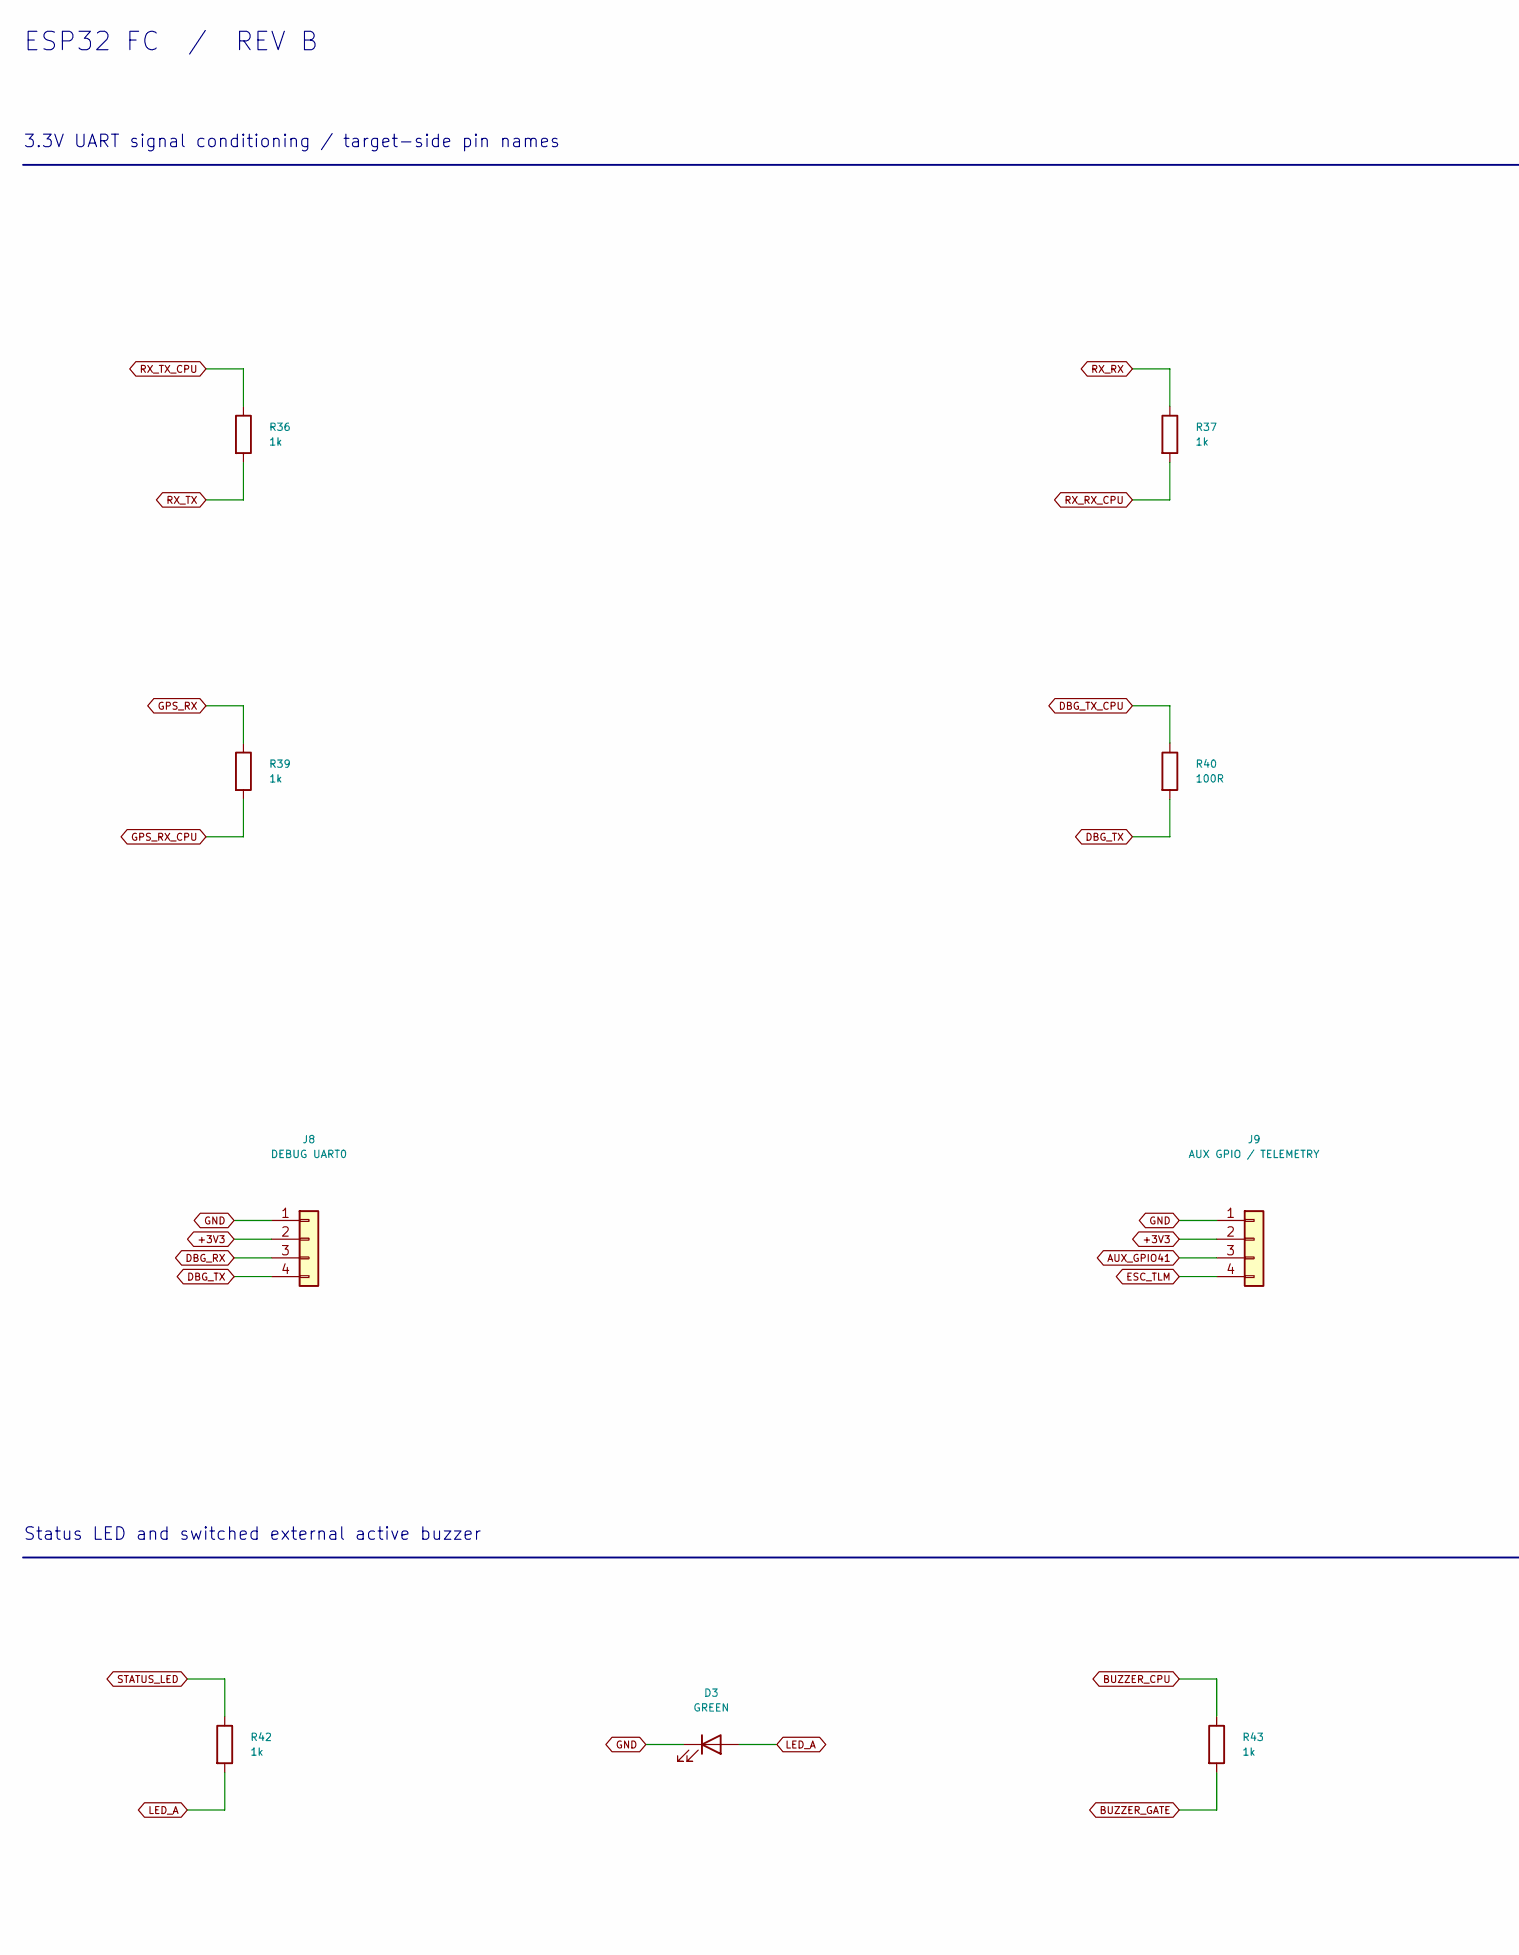
[picture p18: schematic Auxiliary.kicad_sch, 05 Serial ports and indicators, part in row 1, column 1]

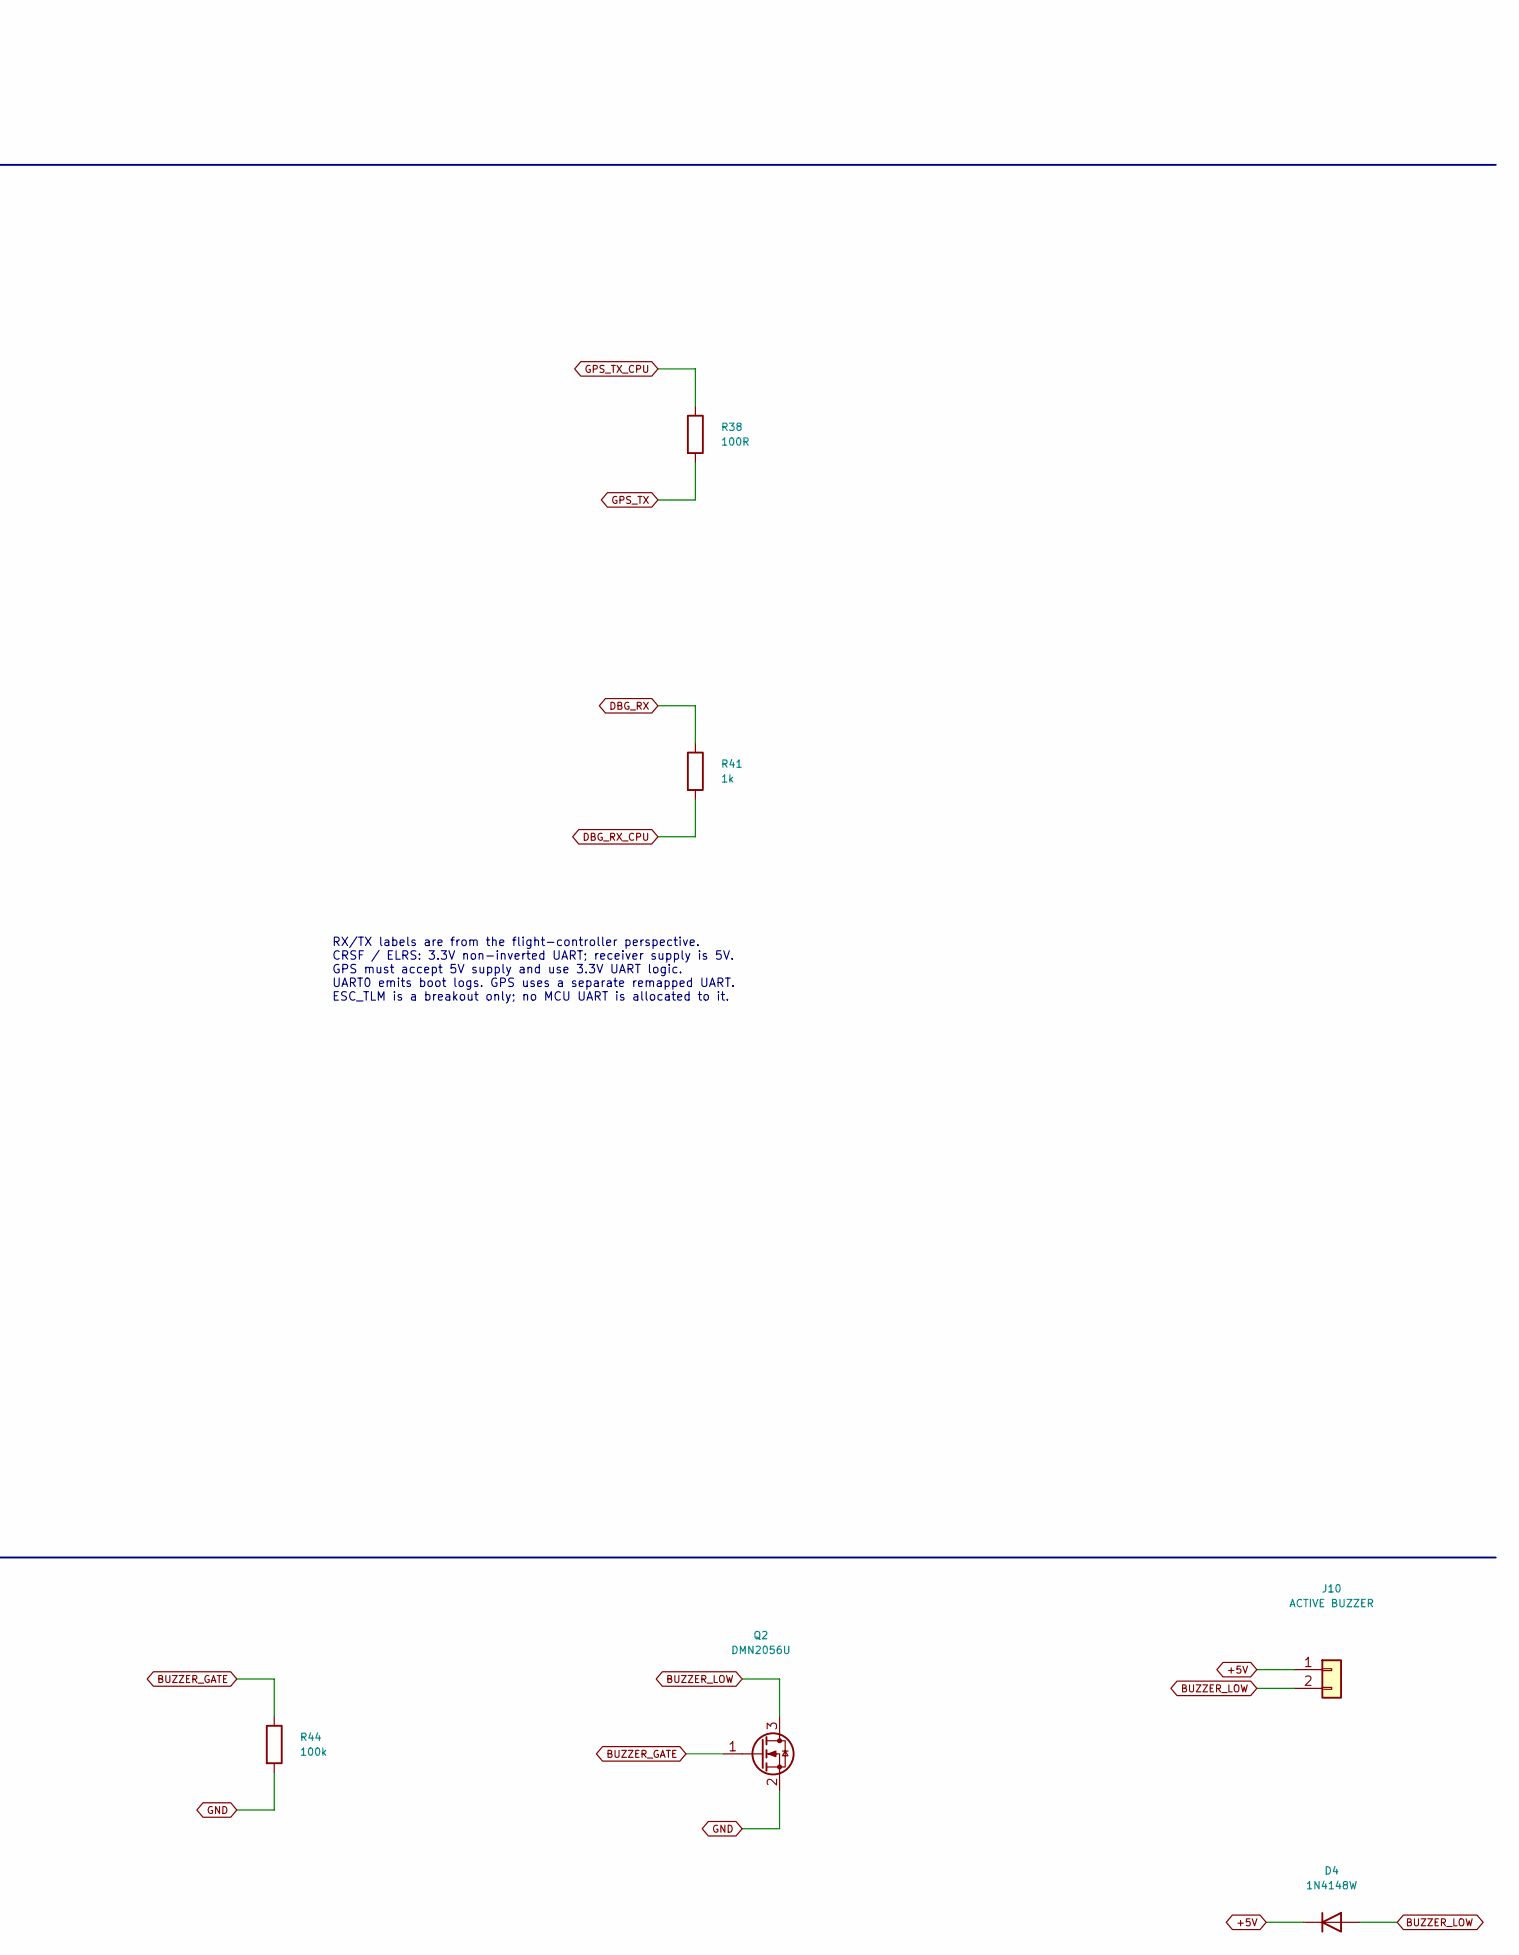
[picture p19: schematic Auxiliary.kicad_sch, 05 Serial ports and indicators, part in row 1, column 2]

Parts:
D3: GREEN; LED_0603_1608Metric; MPN APT1608LZGCK
D4: 1N4148W; D_SOD-123; MPN 1N4148W-7-F
J8: DEBUG UART0; PinHeader_1x04_P2.54mm_Vertical; MPN TSW-104-07-G-S
J9: AUX GPIO / TELEMETRY; PinHeader_1x04_P2.54mm_Vertical; MPN TSW-104-07-G-S
J10: ACTIVE BUZZER; PinHeader_1x02_P2.54mm_Vertical; MPN TSW-102-07-G-S
Q2: DMN2056U; SOT-23; MPN DMN2056U-7
R36, R37, R39, R41, R42, R43: 1k; R_0603_1608Metric; MPN RC0603FR-071KL
R38, R40: 100R; R_0603_1608Metric; MPN RC0603FR-07100RL
R44: 100k; R_0603_1608Metric; MPN RC0603FR-07100KL

Connections:
+3V3: J8.2, J9.2; also elsewhere on the board
+5V: D4.1 (K), J10.1; also elsewhere on the board
AUX_GPIO41: J9.3; also elsewhere on the board
BUZZER_CPU: R43.1; also elsewhere on the board
BUZZER_GATE: Q2.1 (G), R43.2, R44.1
BUZZER_LOW: D4.2 (A), J10.2, Q2.3 (D)
DBG_RX: J8.3, R41.1
DBG_RX_CPU: R41.2; also elsewhere on the board
DBG_TX: J8.4, R40.2
DBG_TX_CPU: R40.1; also elsewhere on the board
ESC_TLM: J9.4; also elsewhere on the board
GND: D3.1 (K), J8.1, J9.1, Q2.2 (S), R44.2; also elsewhere on the board
GPS_RX: R39.1; also elsewhere on the board
GPS_RX_CPU: R39.2; also elsewhere on the board
GPS_TX: R38.2; also elsewhere on the board
GPS_TX_CPU: R38.1; also elsewhere on the board
LED_A: D3.2 (A), R42.2
RX_RX: R37.1; also elsewhere on the board
RX_RX_CPU: R37.2; also elsewhere on the board
RX_TX: R36.2; also elsewhere on the board
RX_TX_CPU: R36.1; also elsewhere on the board
STATUS_LED: R42.1; also elsewhere on the board

Notes on the sheet:
ESP32 FC / REV B
3.3V UART signal conditioning / target-side pin names
RX/TX labels are from the flight-controller perspective. CRSF / ELRS: 3.3V non-inverted UART; receiver supply is 5V. GPS must accept 5V supply and use 3.3V UART logic. UART0 emits boot logs. GPS uses a separate remapped UART. ESC_TLM is a breakout only; no MCU UART is allocated to it.
Status LED and switched external active buzzer
