JS2028EE/ESP32_FC/hardware/revB/ESP32_FC.kicad_pcb

## KiCad design hardware/revB/ESP32_FC.kicad_pcb (continued)

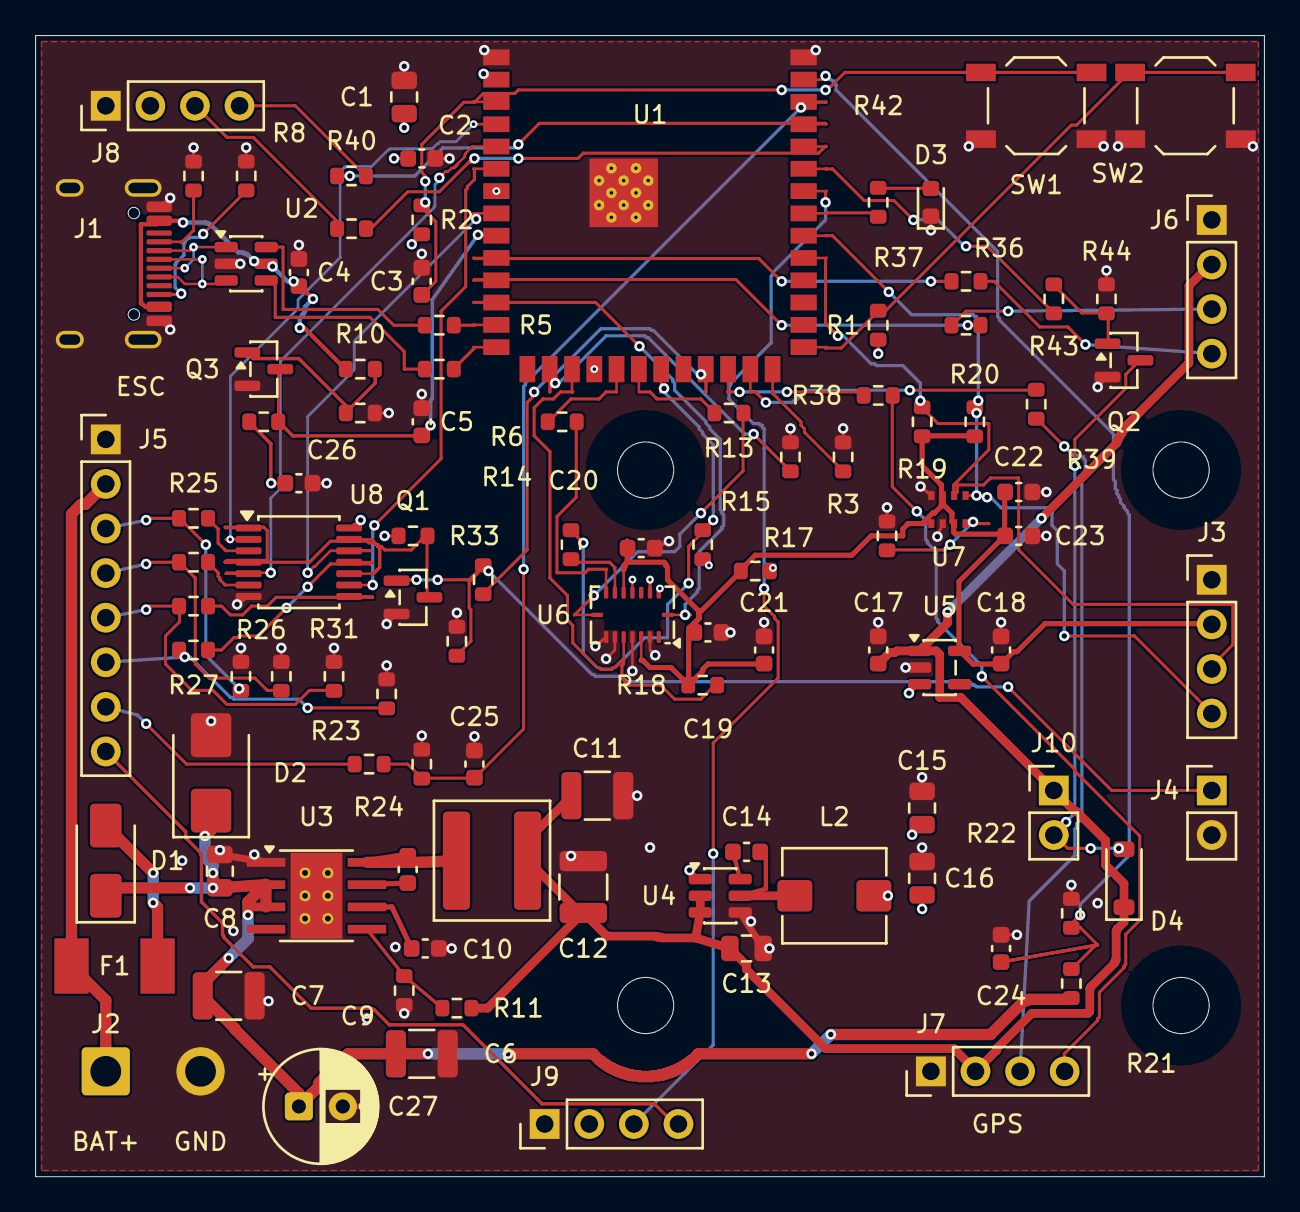
[picture p20: board ESP32_FC.kicad_pcb from above]

Board: 4 copper layers, 70.0 x 65.0 mm, 107 parts (0 on the bottom side), 79 nets.

Other parts of the board:
H1, H2, H3, H4: MountingHole_3.2mm_M3
