JS2028EE/ESP32_FC/(commit log)

2026-10-16 Document Rev B ESP32 flight-controller prototype
2026-10-16 Publish Rev B KiCad design, fabrication files, BOM and complete project documentation
    [Auxiliary.kicad_sch, BOM.csv, Connector_Pin_Map.csv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]
